jacobutermoehlen/SCOUT_RobotDog/Jetson_testCodes/laneFinding/test_image3.jpg

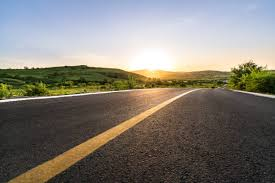
Jetson_testCodes/laneFinding/test_image3.jpg
