jacobutermoehlen/SCOUT_RobotDog/Plakat Texte und Bilder/CAD Design/CADModel.png

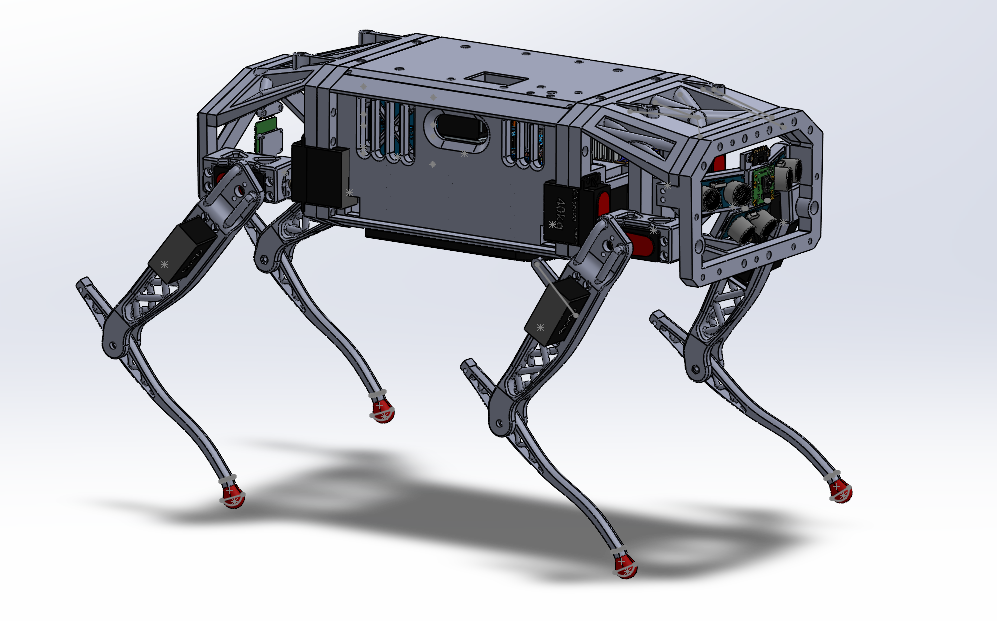
Plakat Texte und Bilder/CAD Design/CADModel.png
