jacobutermoehlen/SCOUT_RobotDog/Plakat Texte und Bilder/CAD Design/CAD-Design_Text.docx

Das 3D-Modell wurde in Solidworks entwickelt und für den 3D-Druck optimiert. Die modulare Bauweise bietet Platz für große Batterien, Sensoren und Kameras. Zudem ermöglicht das Design einfache Upgrades und eine kostengünstige Herstellung.

_____________________________________________________________________
