jacobutermoehlen/SCOUT_RobotDog/Plakat Texte und Bilder/Bewegung/Kinematik/Berechnung der inversen Kinematik.odt

Berechnung der inversen Kinematik

Gesucht:

Winkel ω

Winkel φ

Winkel θ

Gegeben:

Koordinaten = {x, y, z}

Länge A

Länge E

Länge F
