jacobutermoehlen/SCOUT_RobotDog/Vorstellungsablauf_Jacob.odt

- Elektronik
  - Komponentenwahl
  - Welche Komponenten
  - Wie arbeiten sie zusammen?
  - Sensoren
- Gehen und Fortbewegung
  - Gehbewegung der Beine
    - Bezier-Kurve
  - Koordination
  - Schrittart
  - Probleme der Fortbewegung
    - Wackelig
    - Schrittweite, Geschwindigkeit und Synchronisation
  - Testversuche und Teststand
- Software
  - Aufbau
  - Funktionsweise
    - WLAN-Hotspot
    - TCP-Port
  - Threads
  - Was macht der Code?
  - Kamerasystem
  - Autonomie
    - Sensoren
      - GPS, Distanz, Lage IMU
    - Wegfindung
    - Kommunikation mit Benutzer
- Integration
  - Probleme
