jacobutermoehlen/SCOUT_RobotDog/Serial String Communication for HERO.odt

Serial String Communication for HERO

Sensor ESP32

sensor data string

“SENSOUT,[tof_front],[tof_back],[hc_left],[hc_right],[hc_frontLeft],[hc_frontRight],[hc_down], [icm _pitch],[icm_roll],[icm_magX],[icm_magY],[icm_magZ],[icm_temp],[ina_vbus]“
