jacobutermoehlen/SCOUT_RobotDog/Plakat Texte und Bilder/Elektronik/Elektronik.odt

Elektronik

SCOUTs Elektronik System besteht aus über 30 Komponenten und einer selbstgebauten Platine.

Liste aller elektronischen Komponenten:

- 12x RC Servos mit 40kg/cm Drehmoment
- 1x Jetson Orin Nano Der Jetson Orin Nano ist der Hauptcomputer des Roboters. Alle Sensoren werden von einem ESP 32 ausgelesen. Die Sensordaten werden über das I2C Protokoll an der Jetson gesendet.
- 2x ESP 32
- 1x Servokontroller
- 1x DC-DC Konverter 30A
- 2x DC-DC Konverter 3A
- 5x HC-SR04 Ultraschallsensoren
- 2x Laser Distanzsensoren
- 1x 9-Achsen inertiale Messeinhheit
- 1x Spannungsmesser
- 1x Buzzer
- 1x Kamera
- 1x 25.2V LiPo Akku mit 5Ah
