jacobutermoehlen/SCOUT_RobotDog/Plakat Texte und Bilder/Beine und Füße/Foot and Leg_text.docx

Die Beine des Roboters sind robust und widerstandsfähig konstruiert, mit optimierter Druckorientierung für mehr Stabilität. Leistungsstarke Servomotoren mit 40 kg/cm Drehmoment ermöglichen eine präzise Bewegung. Weiche Gummifüße sorgen für besseren Halt auf verschiedenen Oberflächen.

_____________________________________________________________________

Evolution der Beine
