jacobutermoehlen/SCOUT_RobotDog/Plakat Texte und Bilder/Bewegung/Gehen.odt

Gehen

Jedes Bein von SCOUT muss bestimmten Punkten im 3D-Raum folgen, damit eine Gehbewegung erfolgt.

Die erste Gehbewegung sind vier Punkte als Trapez angeordnet gewesen, welche jedes Bein nacheinander durchläuft. Bei Test bemerkten wir schnell, dass das Bein stark wackelt und sich unruhig bewegt.

Wir führten das Problem auf den Weg, den das Bein Folgen muss, zurück. Am Ende des Bodenkontaktes hat sich das Bein ruckartig in die entgegengesetzte Seite bewegt was für die Motoren schwierig ist.

In einem neuen Versuch haben wir den Anfang und Ende des Bodenkontaktes mit einer quadratischen Bezier-Kurve stumpf gemacht, so dass die Richtungsänderung ruhig verläuft und die Motoren unter weniger Belastung Stehen.

Formel der Bezier-Kurve:

Punkte P0, P1 und P2 sind Kontrollpunkte, durch welche die Kurve gesteuert wird. Die Funktion P(t) erstellt Punkte auf dieser Kurve.

Kurven

Wenn SCOUT eine Kurve gehen soll, dann werden alle Wegpunkte des Gehzyklus‘ um Winkel α im 3D-Raum gedreht.

Die neu errechneten Punkte werden den vorderen Beinen zugewiesen, so dass SCOUT eine Kurve läuft.
