jacobutermoehlen/SCOUT_RobotDog/Plakat Texte und Bilder/Software/Software.odt

Software

SCOUTs Softwaresystem besteht hauptsächlich aus einem großen Python Code. Dieser läuft lokal auf dem Jetson Orin Nano und ist zuständig für:

- Kommunikation mit dem GUI
- Berechnung von Wegpunkten der Gehbewegung
- Berechnung der Kinematik
- Steuerung und Koordination der Motoren

Der Code ist in Threads aufgeteilt. Threads sind Codeabschnitte die parallel zueinander auf verschiedenen CPU-Kernen ausgeführt werden. Dadurch kann z.B. dauerhaft zwischen mit dem GUI kommuniziert werden während gleichzeitig die Motoren gesteuert werden.
