jacobutermoehlen/SCOUT_RobotDog/Plakat Texte und Bilder/Bewegung/bewegung bilder und texte/Geh-Bewegung_Text.docx

Quadratische Bézier-Kurven wurden verwendet, um ungewollte Richtungsänderungen zu vermeiden und die Bewegung flüssiger zu gestalten. Sie passen die Geschwindigkeit und Richtung sanft an, wodurch die Gehbewegung gleichmäßiger wird. Die Schrittweite ist variabel und hängt von der Distanz der gespiegelten Kurven ab.

________________________________________
