jacobutermoehlen/SCOUT_RobotDog/Drawings/Flowchart_ServoESP32.drawio.pdf

# Servo ESP32

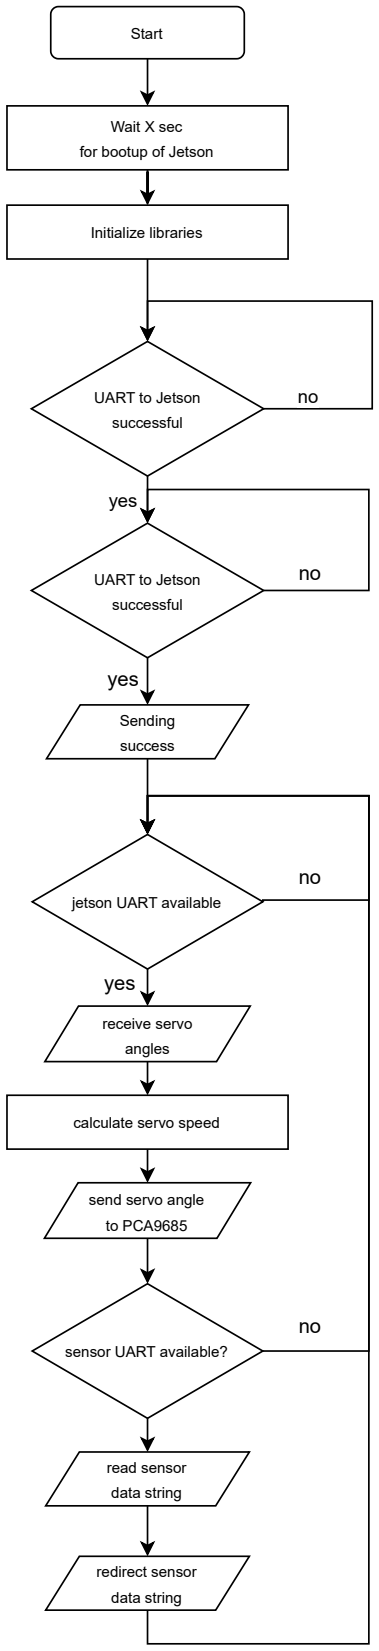
[picture p29: figure]
Start; Wait X sec for bootup of Jetson; Initialize libraries; yes; UART to Jetson successful; Sending success; sensor UART available?; read sensor data string; jetson UART available; redirect sensor data string; receive servo angles; calculate servo speed; send servo angle to PCA9685
