jacobutermoehlen/SCOUT_RobotDog/Plakat Texte und Bilder/Bewegung/Kinematik/Kinematik2.odt

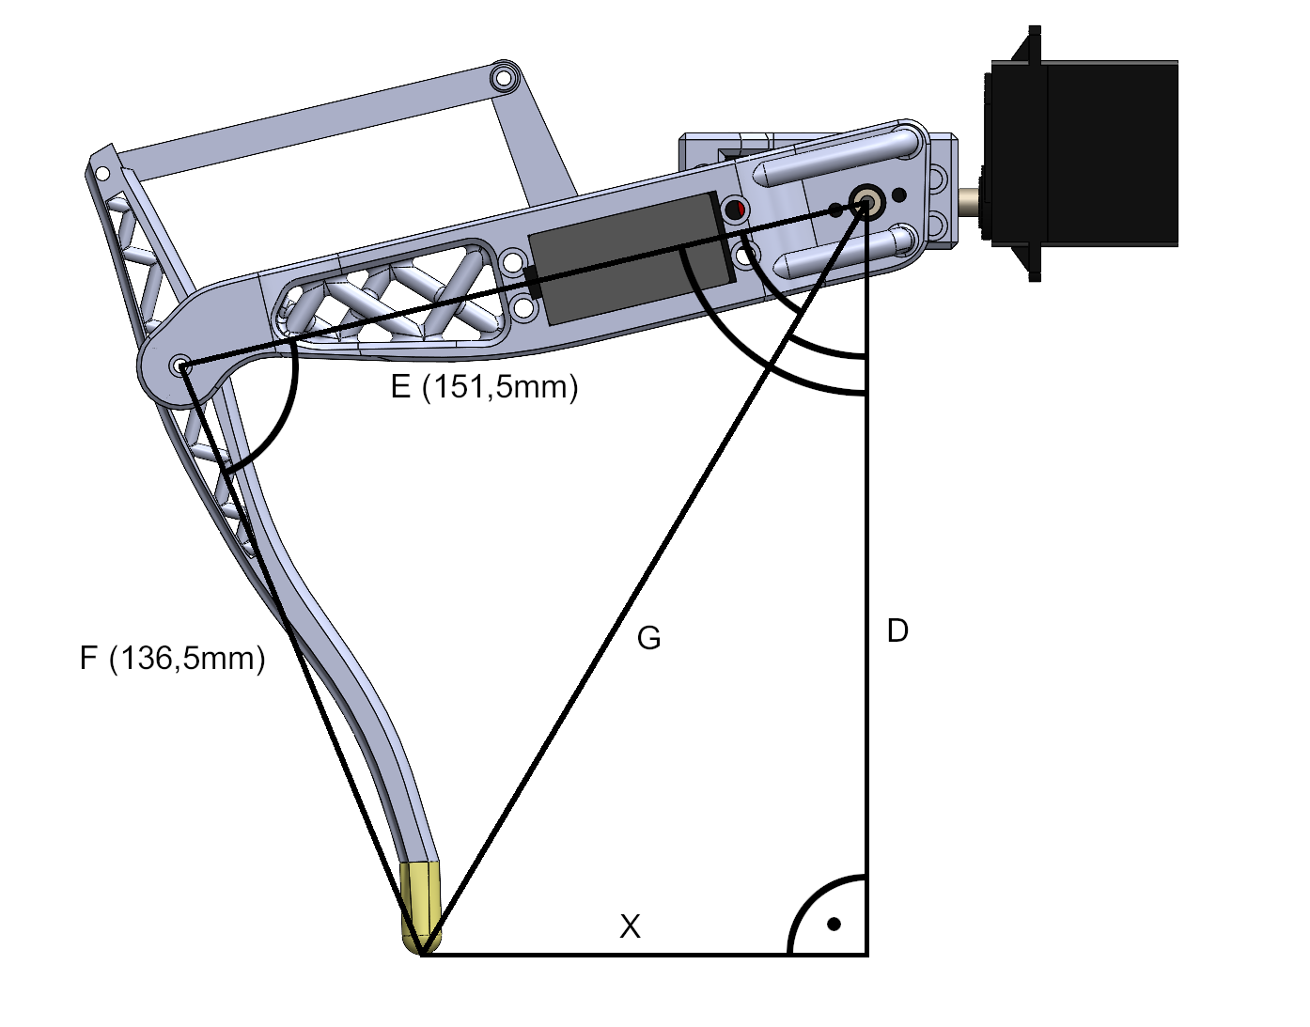
[picture p30: figure]
