jacobutermoehlen/SCOUT_RobotDog/Plakat Texte und Bilder/Bewegung/Kinematik/Berechnung der inversen Kinematik_eng.pdf

C = √Z
2 + Y

2

D = √C
2 − A

2

= √√Z
2 + Y

2 − A

2

α = tan⁻¹

Z
Y

β = tan⁻¹

D
A
ω = α + β

needed:

angle ω

angle φ

angleθ

given:

coordinates = {x, y, z}

length A

length E

length F

G = √D² + X
2

G

2 = E

2 + F

2 − 2EF × cos φ

φ = cos⁻¹

G

2 − E

2 − F

2
−2EF

γ = tan⁻¹

(

X
D

)

δ = sin⁻¹

(

sinφ
G

× F)

θ = γ + δ

ω = tan⁻¹

Z
Y

+ tan⁻¹

√√Z
2 + Z

2 − A

2
A

φ = cos⁻¹

G

2 − E

2 − F

2
−2EF

θ = tan⁻¹

(

X
D

) + sin⁻¹ (
sin (cos⁻¹

(

G

2 − E

2−F

2
−2EF ))

G

× F)
