jacobutermoehlen/SCOUT_RobotDog/3DParts/LowerLeg-Static 1/LowerLeg-Static 1-Displacement-Displacement1.jpg

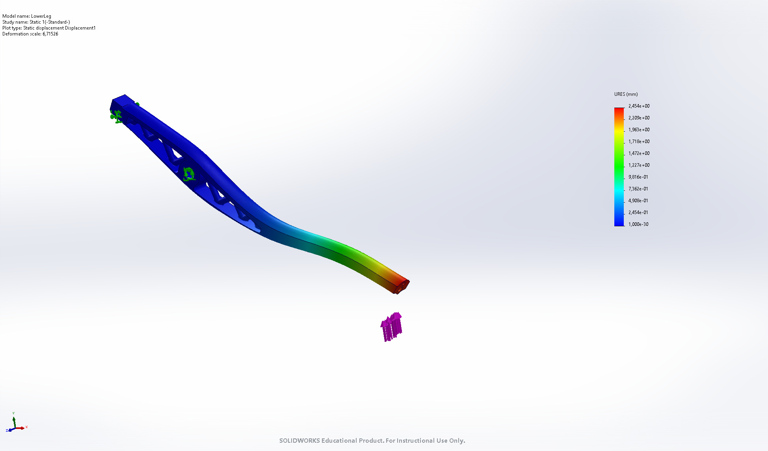
3DParts/LowerLeg-Static 1/LowerLeg-Static 1-Displacement-Displacement1.jpg
