jacobutermoehlen/SCOUT_RobotDog/Images/015D5AFA-F840-42FB-8E8E-D22241E1A85D.JPG

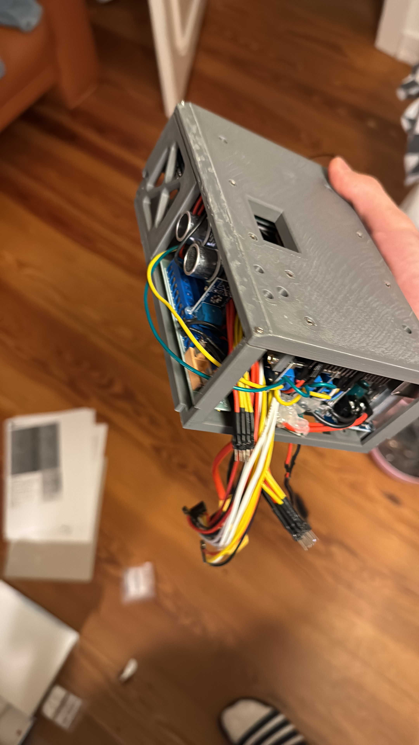
Images/015D5AFA-F840-42FB-8E8E-D22241E1A85D.JPG
