jacobutermoehlen/SCOUT_RobotDog/Images/BDSpotReference.jpg

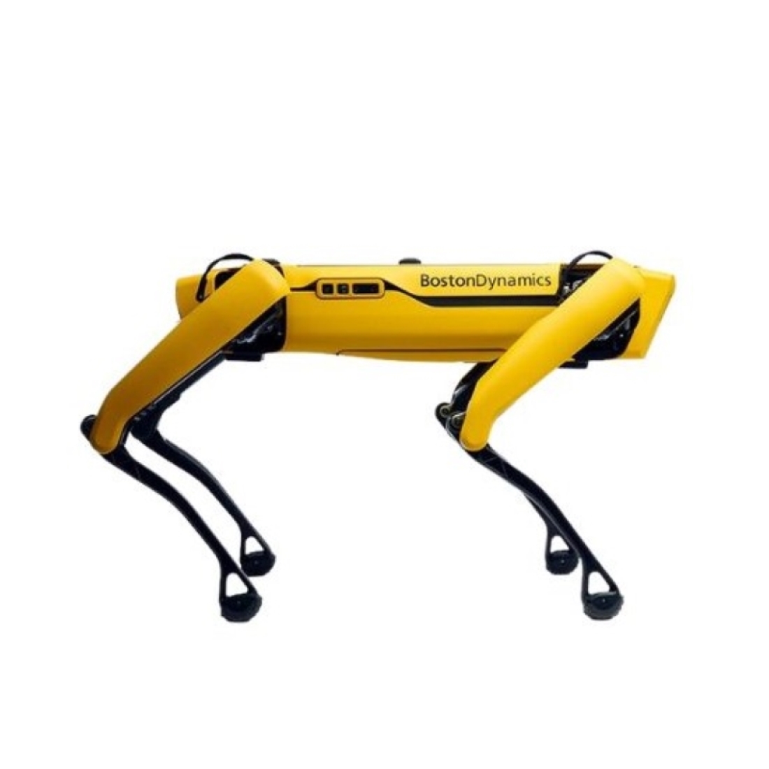
Images/BDSpotReference.jpg
