jacobutermoehlen/SCOUT_RobotDog/Images/IMG_0658.jpg

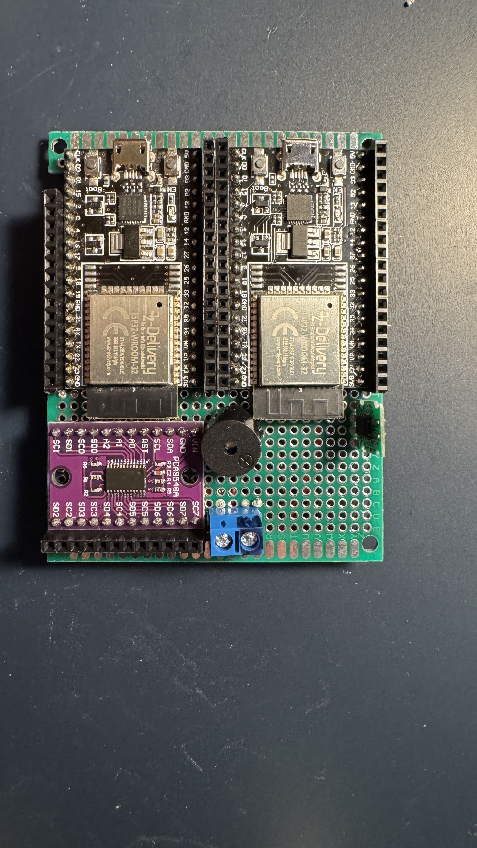
Images/IMG_0658.jpg
