jacobutermoehlen/SCOUT_RobotDog/Images/IMG_0659.jpg

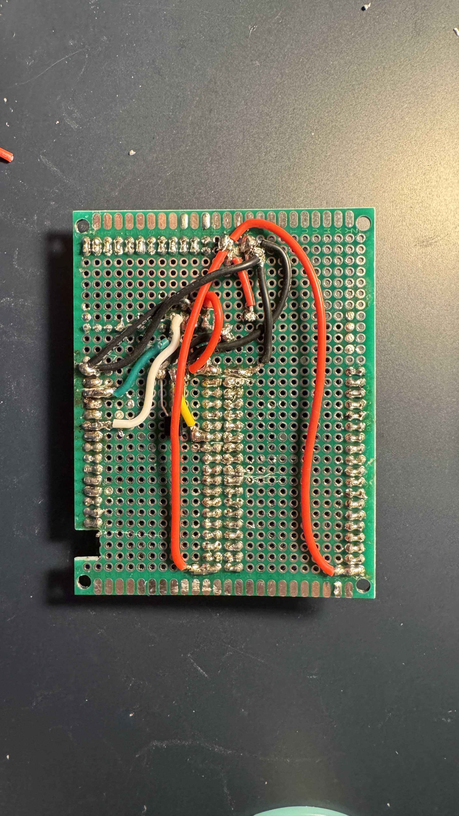
Images/IMG_0659.jpg
