jacobutermoehlen/SCOUT_RobotDog/Images/IMG_0660.jpg

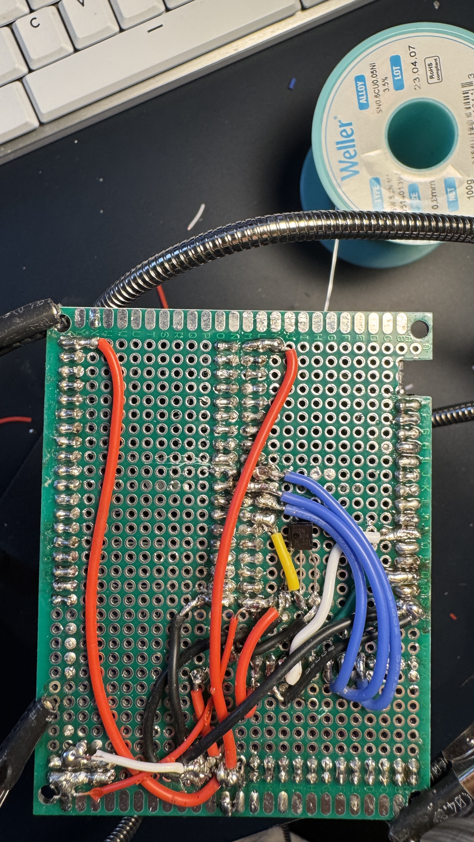
Images/IMG_0660.jpg
