jacobutermoehlen/SCOUT_RobotDog/Images/IMG_0661.jpg

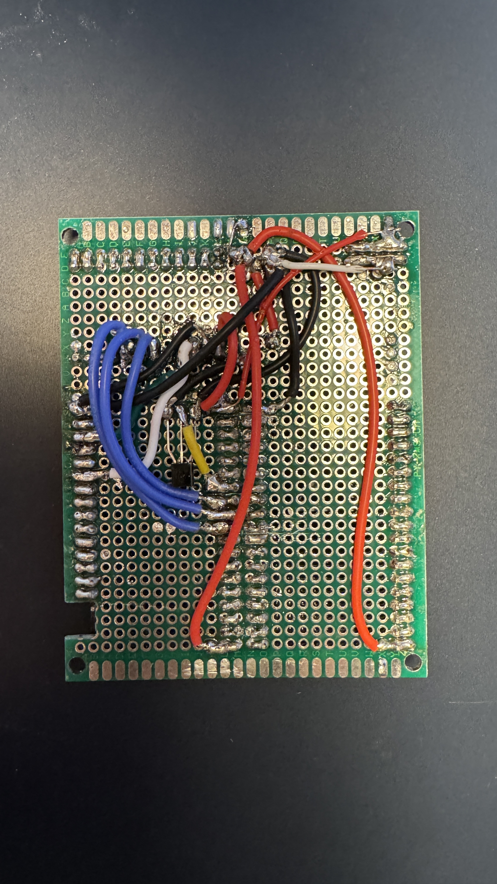
Images/IMG_0661.jpg
