jacobutermoehlen/SCOUT_RobotDog/Images/IMG_0662.jpg

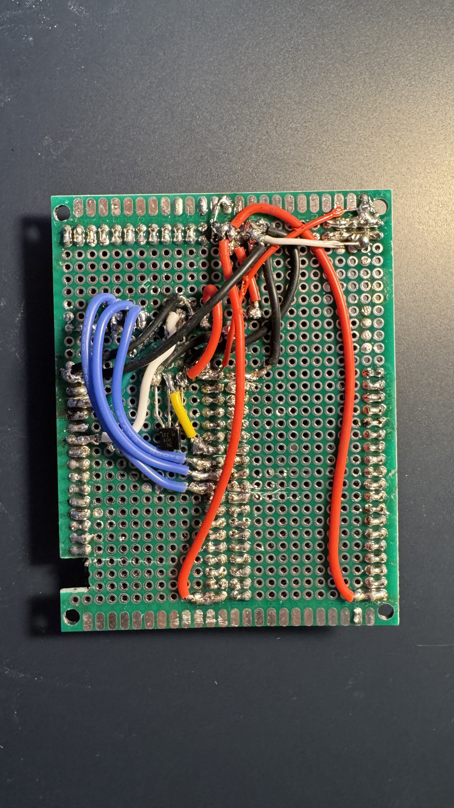
Images/IMG_0662.jpg
