jacobutermoehlen/SCOUT_RobotDog/Images/IMG_0664.jpg

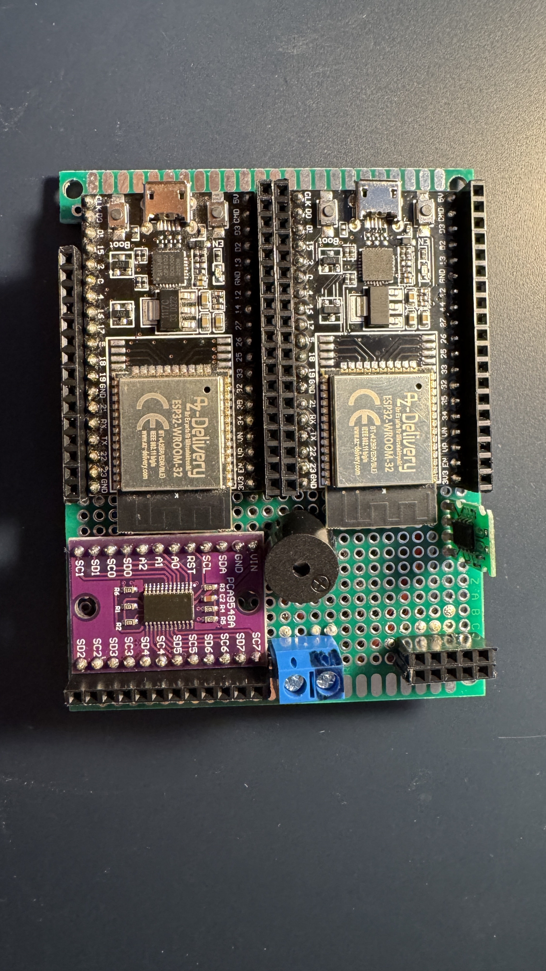
Images/IMG_0664.jpg
