jacobutermoehlen/SCOUT_RobotDog/Images/IMG_0666.jpg

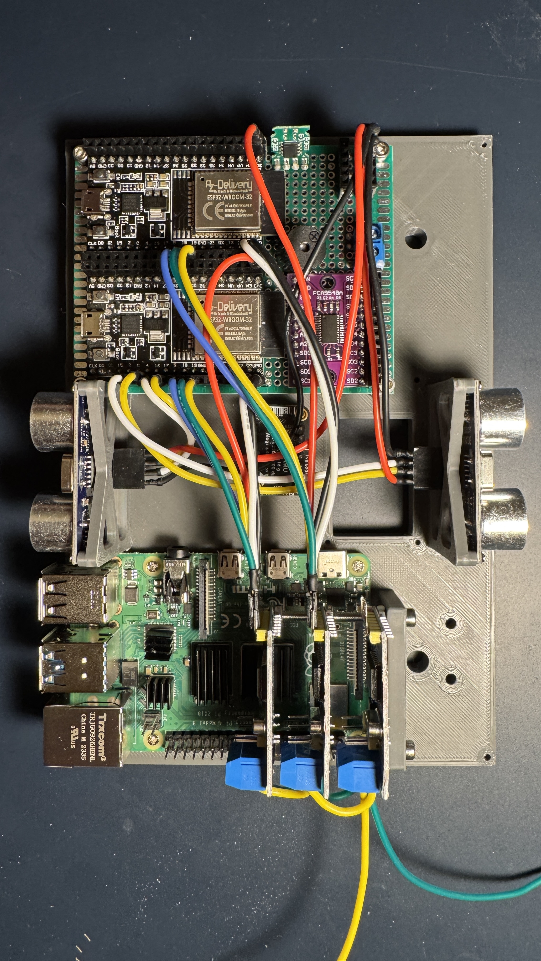
Images/IMG_0666.jpg
