jacobutermoehlen/SCOUT_RobotDog/Images/IMG_0667.jpg

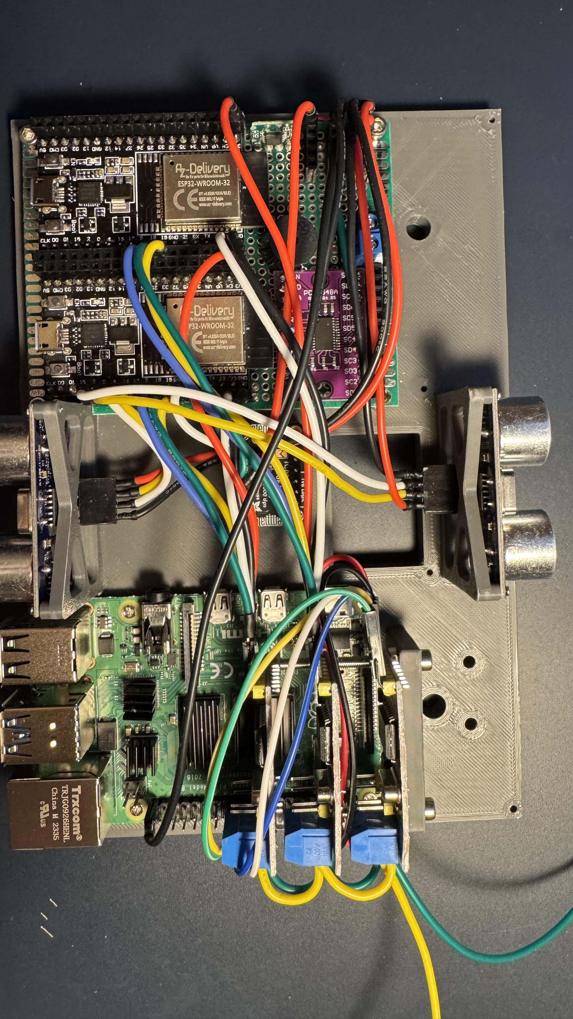
Images/IMG_0667.jpg
