jacobutermoehlen/SCOUT_RobotDog/Images/IMG_0668.jpg

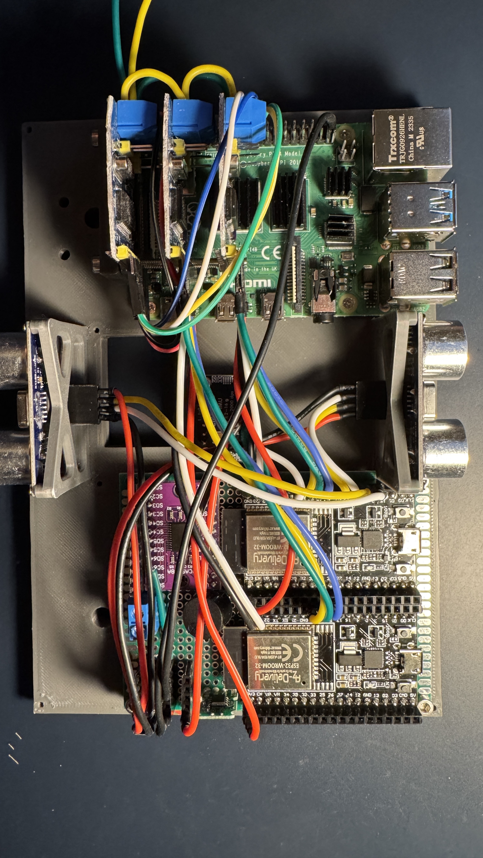
Images/IMG_0668.jpg
