jacobutermoehlen/SCOUT_RobotDog/Images/IMG_0670.jpg

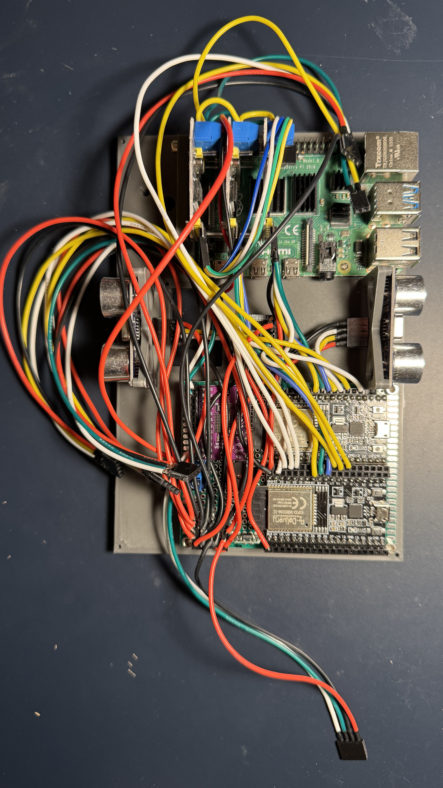
Images/IMG_0670.jpg
