jacobutermoehlen/SCOUT_RobotDog/Images/IMG_0671 1.jpg

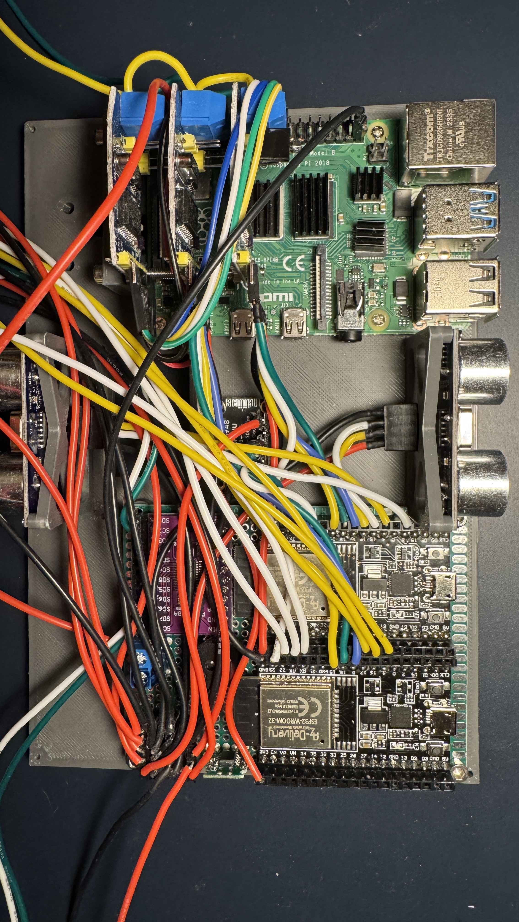
Images/IMG_0671 1.jpg
