jacobutermoehlen/SCOUT_RobotDog/Images/IMG_0674.jpg

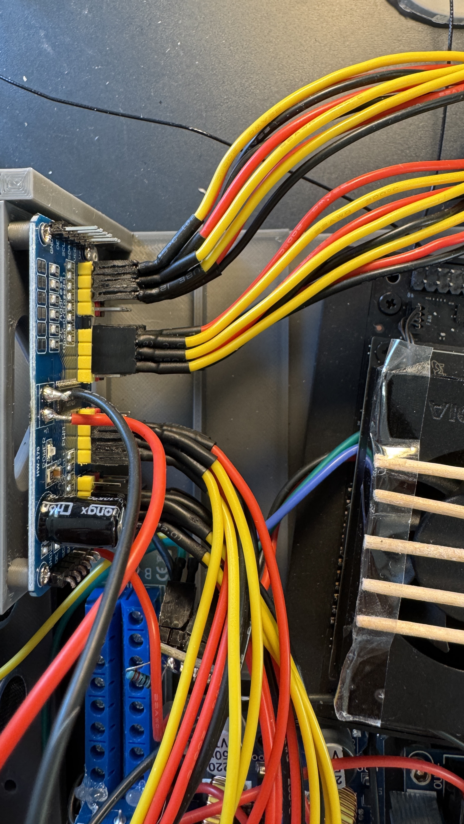
Images/IMG_0674.jpg
