jacobutermoehlen/SCOUT_RobotDog/Images/IMG_0720.jpg

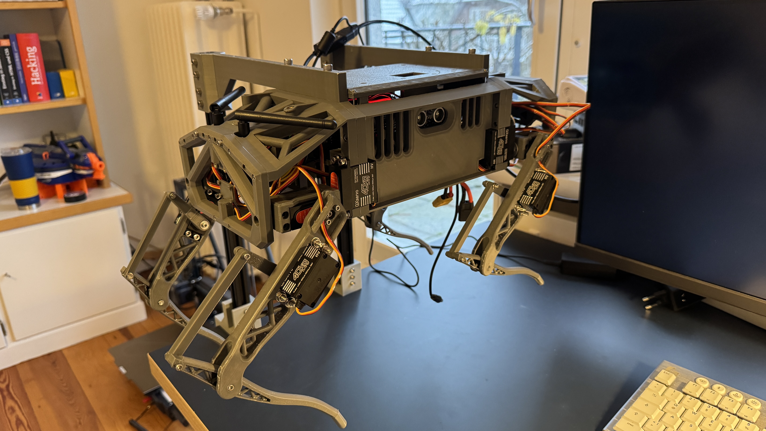
Images/IMG_0720.jpg
