jacobutermoehlen/SCOUT_RobotDog/Images/KinematicsCalculation1.png

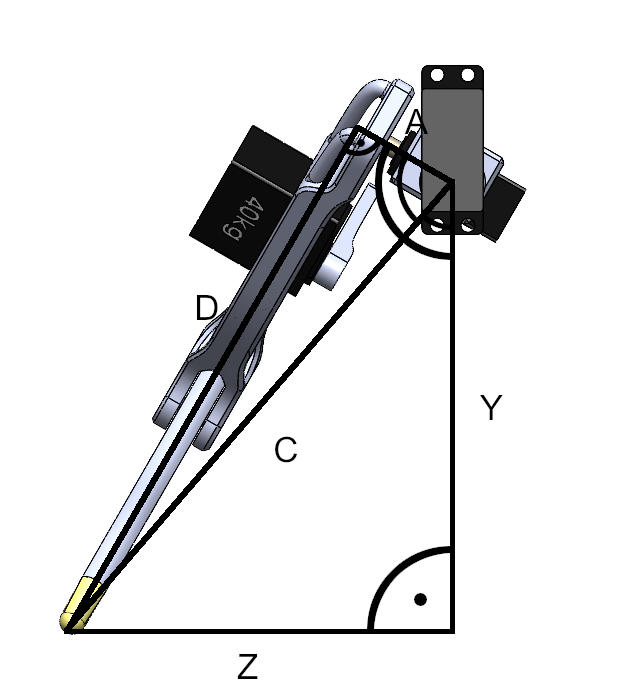
Images/KinematicsCalculation1.png
