jacobutermoehlen/SCOUT_RobotDog/Images/LowerLeg_Stress_10N.png

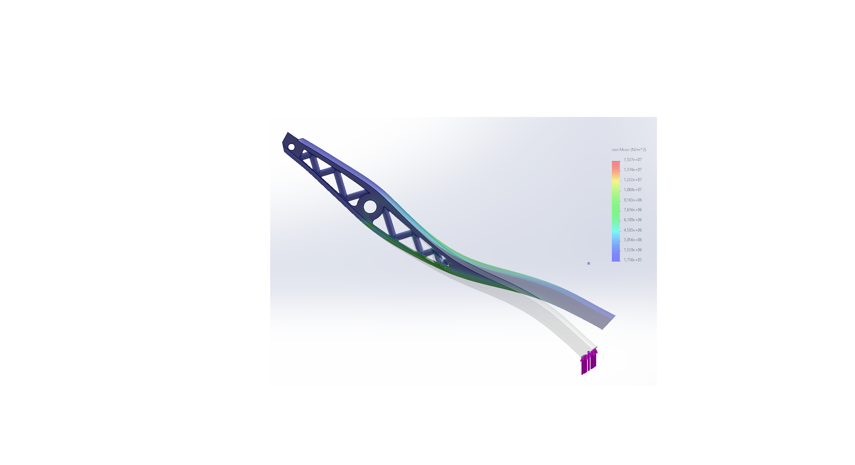
Images/LowerLeg_Stress_10N.png
