jacobutermoehlen/SCOUT_RobotDog/Images/SCOUTinVirtualEnviroment.png

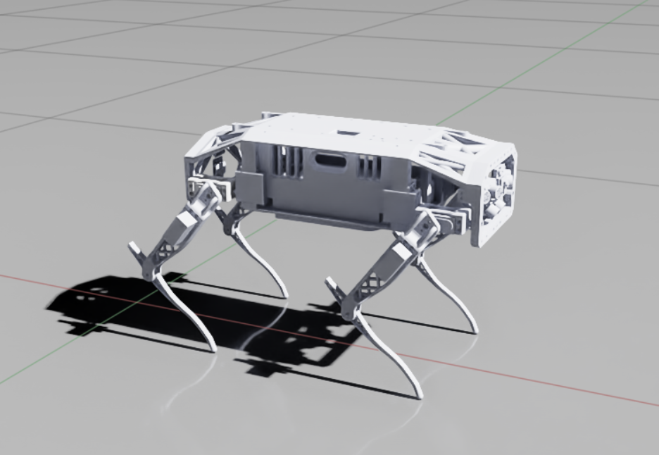
Images/SCOUTinVirtualEnviroment.png
