jacobutermoehlen/SCOUT_RobotDog/Images/Screenshot 2024-10-02 110427.png

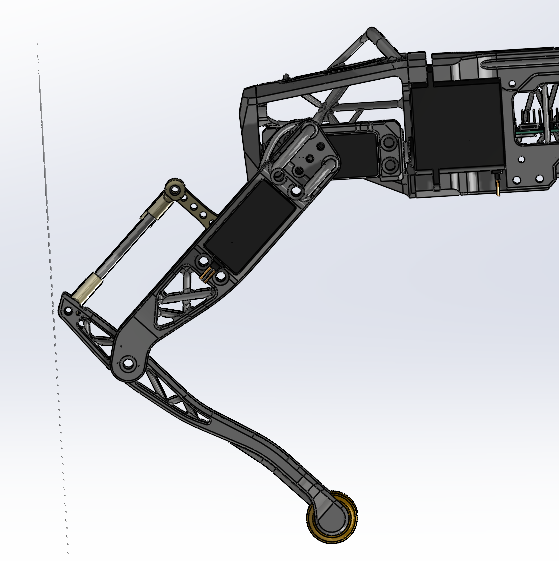
Images/Screenshot 2024-10-02 110427.png
