jacobutermoehlen/SCOUT_RobotDog/Images/Screenshot 2025-01-12 144651.png

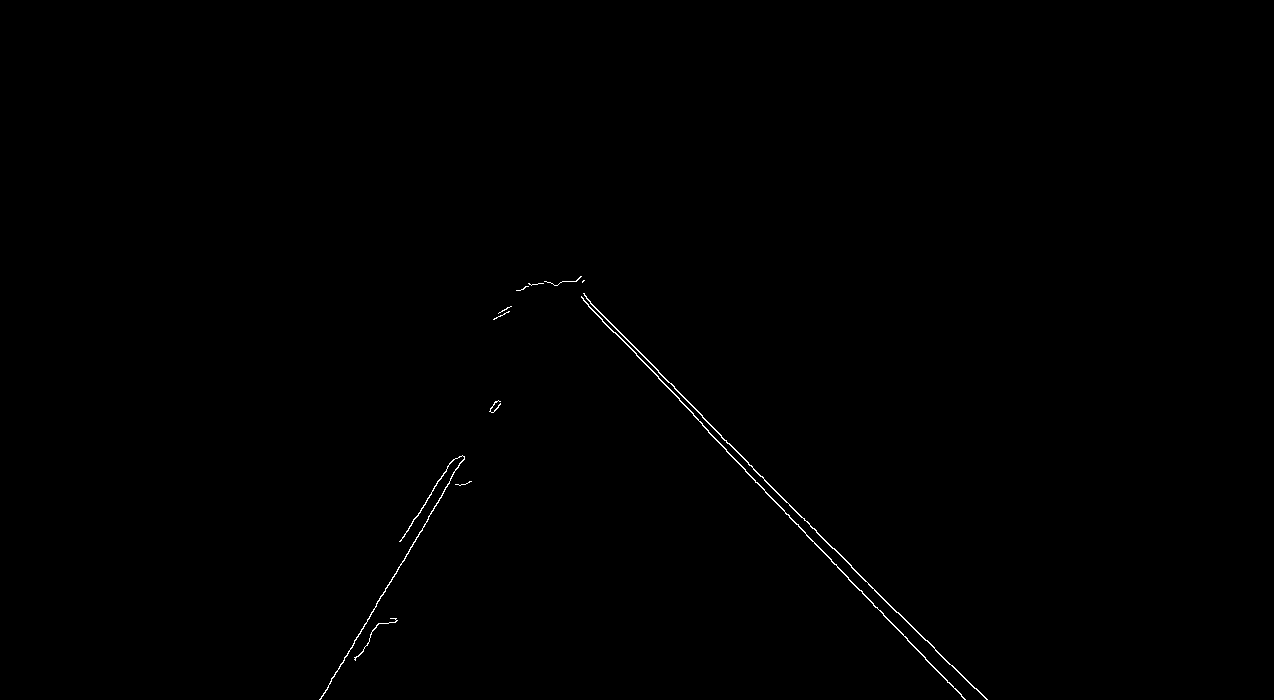
Images/Screenshot 2025-01-12 144651.png
