jacobutermoehlen/SCOUT_RobotDog/Images/Screenshot 2025-02-14 063028.png

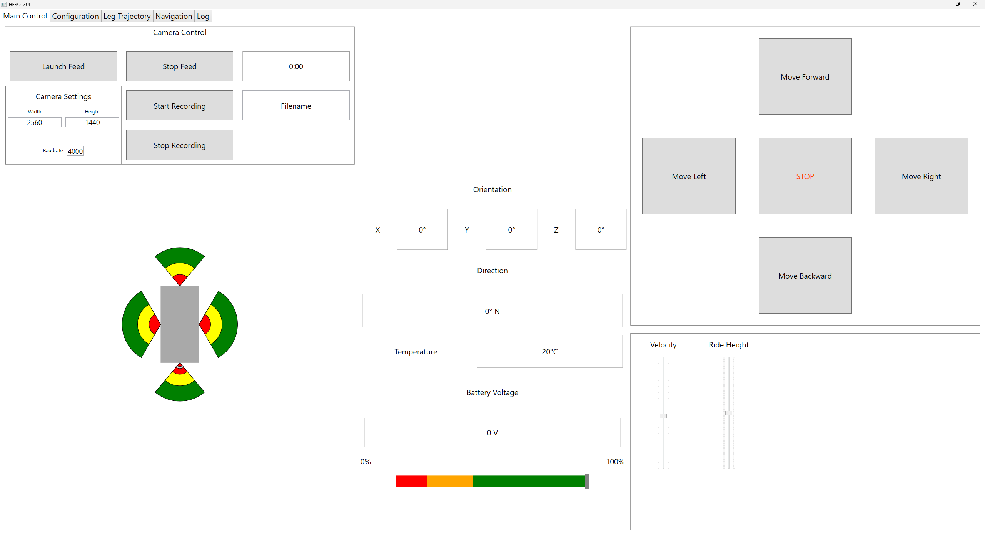
Images/Screenshot 2025-02-14 063028.png
