jacobutermoehlen/SCOUT_RobotDog/Images/Screenshot 2025-05-04 125850.png

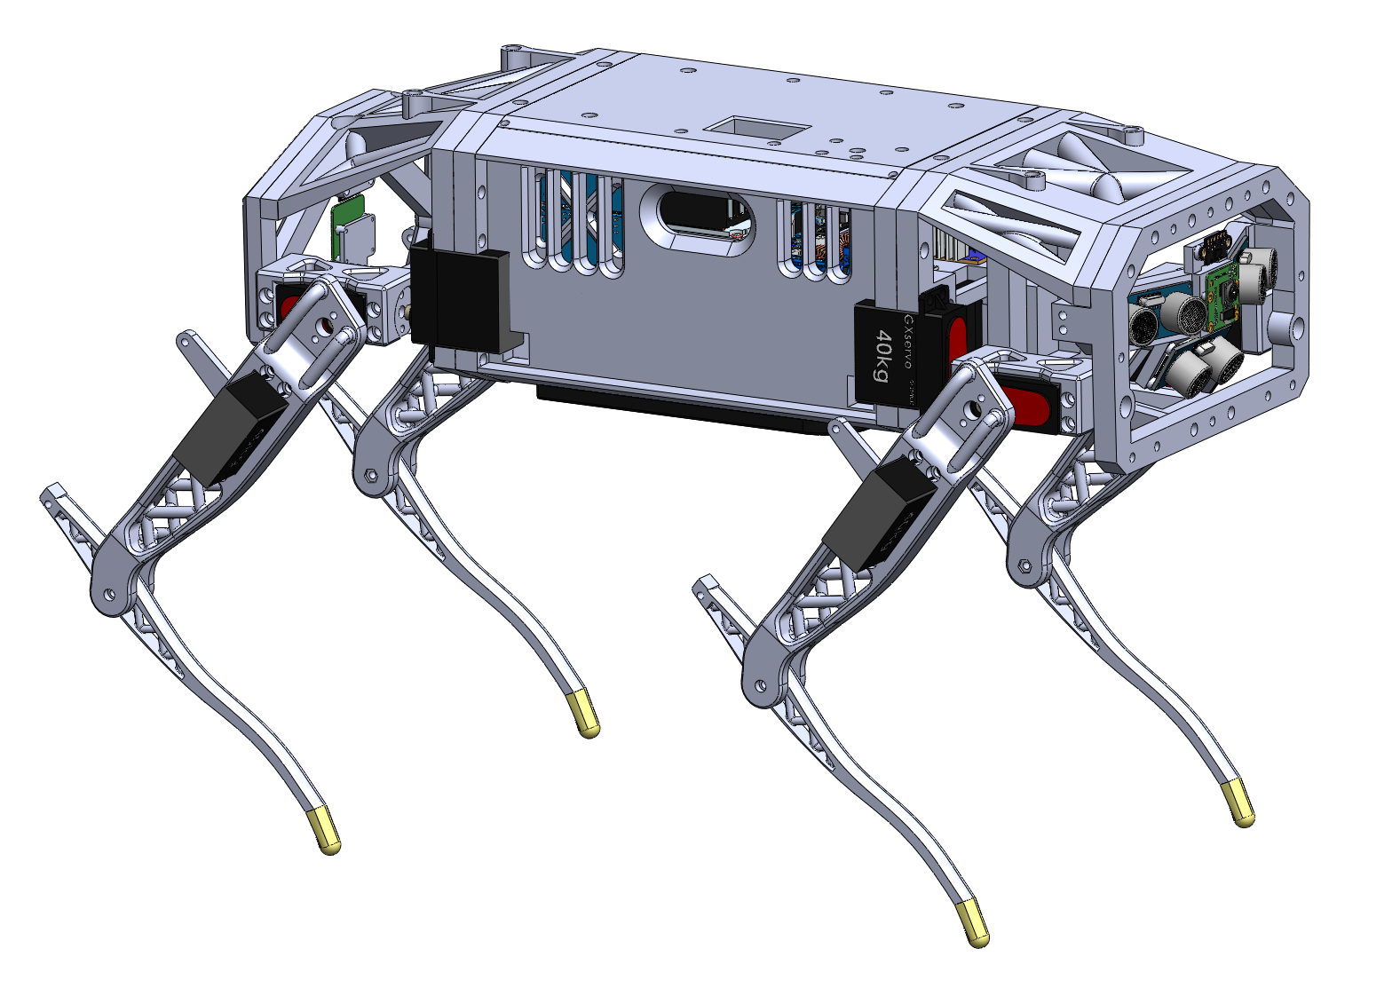
Images/Screenshot 2025-05-04 125850.png
