jacobutermoehlen/SCOUT_RobotDog/Plakat Texte und Bilder/Beine und Füße/Foots.jpg

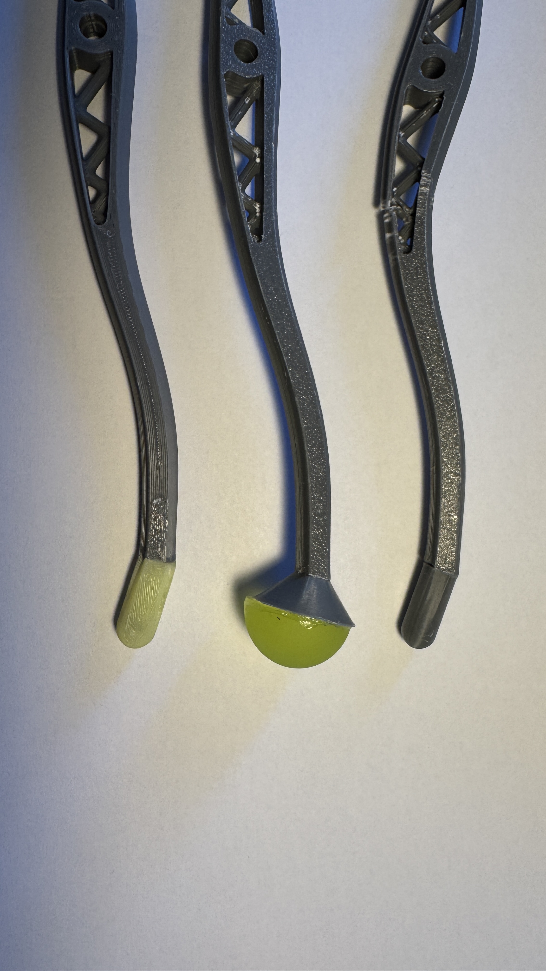
Plakat Texte und Bilder/Beine und Füße/Foots.jpg
