jacobutermoehlen/SCOUT_RobotDog/Plakat Texte und Bilder/Beine und Füße/Leg.png

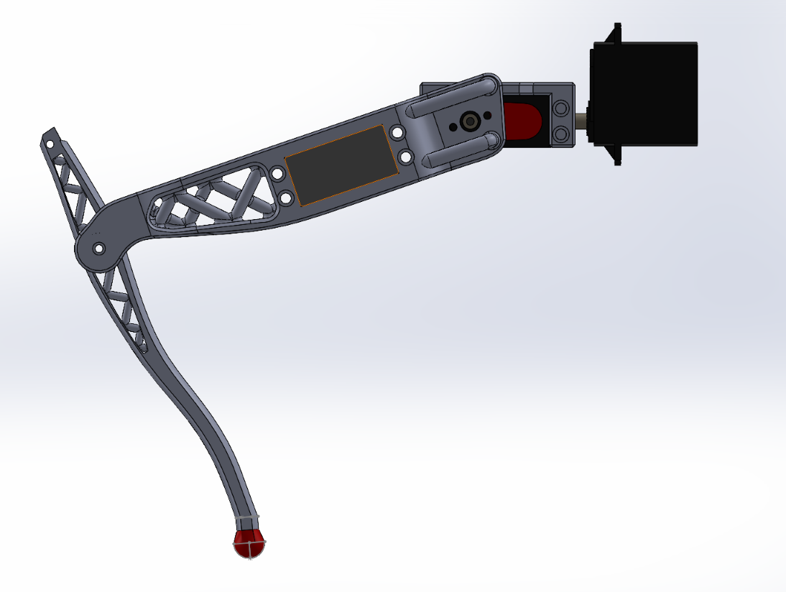
Plakat Texte und Bilder/Beine und Füße/Leg.png
