jacobutermoehlen/SCOUT_RobotDog/Plakat Texte und Bilder/Bewegung/Kinematik/Screenshot 2025-02-09 204644.png

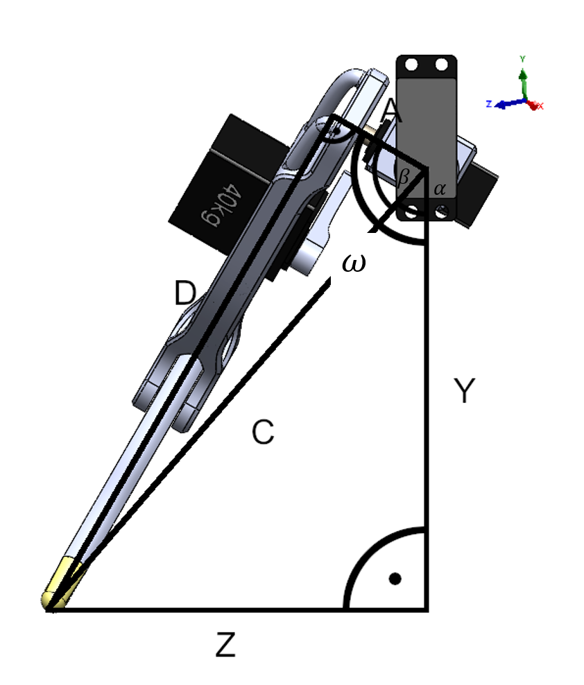
Plakat Texte und Bilder/Bewegung/Kinematik/Screenshot 2025-02-09 204644.png
