jacobutermoehlen/SCOUT_RobotDog/Plakat Texte und Bilder/CAD Design/BDSpotReference.png

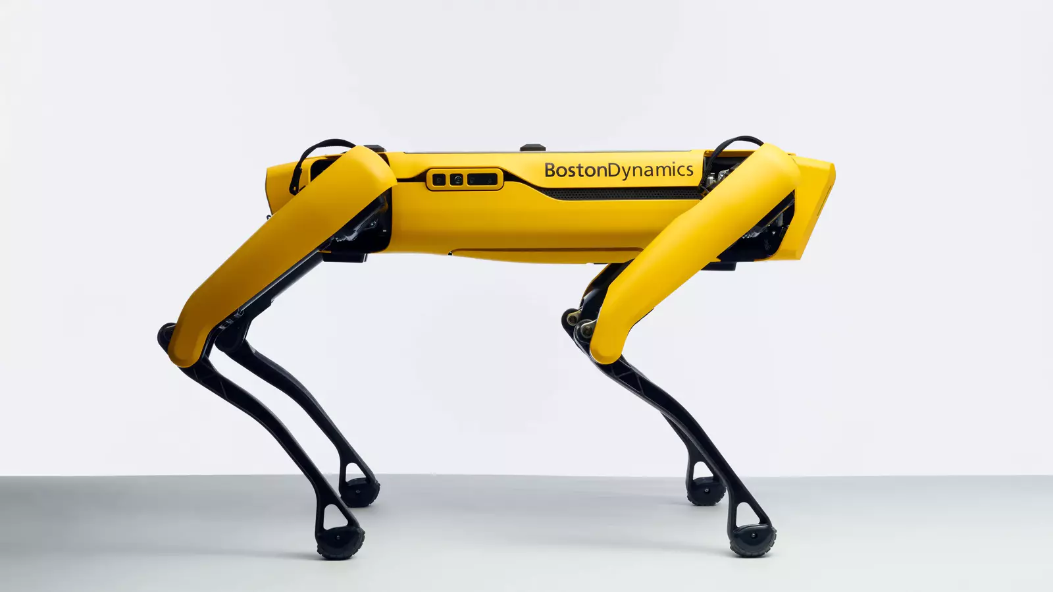
Plakat Texte und Bilder/CAD Design/BDSpotReference.png
