jacobutermoehlen/SCOUT_RobotDog/Partlist for bangle.xlsx

Produkt | Funktion | Preis | Anzahl | Paket Anzahl | Link | Gesamtpreis
H31 batterie 3,7 500 v 3,7 mah | Energie versorgung | 2.69 € | 1 | 1 | Klick Hier (https://de.aliexpress.com/item/1005007782013064.html?mp=1) | 2.69 €
TF Micro SD-Kartenmodu | Speicherung der Audiodatein | 2.69 € | 10 | 1 | Klick Hier (https://de.aliexpress.com/item/1005006247350757.html?mp=1) | 2.69 €
Tactile Push Button | Aktivierung der Audioeingabe | 1.79 € | 20 | 1 | Klick Hier (https://de.aliexpress.com/item/1005007078128171.html?mp=1) | 1.79 €
ESP-WROOM-32 ESP32-S entwicklung board | Computer/ Steuersystem | 6.39 € | 1 | 1 | Klick Hier (https://de.aliexpress.com/item/1005006490116433.html?mp=1) | 6.39 €
SPH0645 I2S MEMS Mikrofon | Aufnahme des Audios | 4.39 € | 1 | 1 | Klick Hier (https://de.aliexpress.com/item/4000059212862.html?mp=1) | 4.39 €
Gesamt: |  | 17.95 € |  |  |  | 17.95 €
