jacobutermoehlen/SCOUT_RobotDog/PartList.xlsx

 | Name | Info | Pack Anzahl | Bestellanzahl | Gesamtanzahl | URL | Preis pro Pack | Preis insgesamt | Bestellt | Vorhanden | Ausgezahlt | Auszahlungswert | Versand
Elektronik | Raspberry Pi | Raspberry Pi4 4Gb | 1 | 1 | 1 | Hier Klicken (https://www.amazon.de/gp/product/B09TTNF8BT/ref=ox_sc_act_title_5?smid=A1JDLVO3NW19TT&psc=1) | 60.49 € | 60.49 € | TRUE | TRUE | FALSE | 60.49
 | SanDisk Ultra 256Gb | - | 1 | 1 | 1 | Hier Klicken (https://www.amazon.de/gp/product/B0B7NV73PJ/ref=ox_sc_act_title_19?smid=A3JWKAKR8XB7XF&psc=1) | 19.03 € | 19.03 € | TRUE | TRUE | FALSE | 19.03
 | Gxservo 40kg | 40kg RC Servo QY3240MG Digital Servo 7.4V | 1 | 12 | 12 | Hier Klicken (https://de.aliexpress.com/item/1005005565497730.html?mp=1) | 14.91 € | 178.92 € | TRUE | TRUE | FALSE | 178.92
 | Haileg PCA9685 Servoboard | Hailege 2pcs PCA9685 16 Kanal IIC I2C 12-Bit PWM Servomotor | 1 | 1 | 1 | Hier Klicken (https://de.aliexpress.com/item/1005006342114169.html) | 5.21 € | 5.21 € | TRUE | TRUE | FALSE | 5.21
 | Turnigy Rapid 5000mAh 6s Lipo | 5000mAh 6s (22,2) 100C LiPo Battery Pack w/XT90 Connector | 1 | 1 | 1 | Hier Klicken (https://hobbyking.com/de_de/turnigy-rapid-5000mah-6s-22-2v-100c-lipo-battery-pack-w-xt90-connector.html) | 42.00 € | 42.00 € | TRUE | TRUE | FALSE | 42
 | APKLVSR Pi Kamera 5MP | 1080p Kamera mit Nachtsicht | 1 | 1 | 1 | Hier Klicken (https://www.amazon.de/APKLVSR-Kompatibel-Kameramodul-Einstellbare-Infrarot-IR-LED-Licht/dp/B0CLGTM3Z8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) | 11.59 € | 11.59 € | TRUE | TRUE | FALSE | 11.59
 | Servo Tester | Servo Tester 4,2-6V 3-Gang-Schalter | 1 | 1 | 1 | Hier Klicken (https://de.aliexpress.com/item/1005007097121696.html?mp=1) | 1.55 € | 1.55 € | FALSE | FALSE | FALSE | 0
 | XL6009 4A Converter |  | 5 | 1 | 5 | Hier Klicken (https://de.aliexpress.com/item/1005006954848559.html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) | 4.19 € | 4.19 € | FALSE | FALSE | FALSE | 0
 | On Off Schalter | Kippschalter schwarz | 5 | 1 | 5 | Hier Klicken (https://de.aliexpress.com/item/32873386670.html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) | 1.19 € | 1.19 € | FALSE | FALSE | FALSE | 0
 | 4A Sicherung Wiederverwendbar | rücksetbarer Leistungsschalter 4A max. | 5 | 1 | 5 | Hier Klicken (https://de.aliexpress.com/item/1005006243840332.html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) | 4.37 € | 4.37 € | TRUE | FALSE | FALSE | 4.37
 | Notfall Stop | 22mm Notfallstop Mushroom Push Button 600V/10A | 1 | 1 | 1 | Hier Klicken (https://de.aliexpress.com/item/4000350288660.html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) | 1.89 € | 1.89 € | FALSE | FALSE | FALSE | 0
 | ESP32-C6 DevKit | ESP32-C6 DevKit 512Kb Sram 4Mb Flash WiFi-6 | 2 | 1 | 2 | Hier Klicken (https://www.amazon.de/ESP32-C6-DevKitC-1-N4-Entwicklungsplatine-RUIZHI-Unterst%C3%BCtzt-Schnittstelle/dp/B0CPY6NV6L) | 14.99 € | 14.99 € | FALSE | FALSE | FALSE | 0
 | Raspberry Pi Kühlkörper Alu | GeekPi Kühlkörper für Raspberry Pi 4 | 8 | 1 | 8 | Hier Klicken (https://www.amazon.de/gp/product/B085G73SCB/ref=ppx_yo_dt_b_asin_title_o00_s01?ie=UTF8&th=1) | 4.99 € | 4.99 € | TRUE | TRUE | FALSE | 4.99
 | HC-SR04 Ultrasonic sensor | HC-SR04 Ultraschall Distanzsensor | 5 | 1 | 5 | Hier Klicken (https://www.amazon.de/HC-SR04-Ultraschall-Sensor-Ultraschallsensor-Arduino-MEGA2560/dp/B07XF4815H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) | 15.78 € | 15.78 € | TRUE | TRUE | FALSE | 15.78 | 4
 | Turnigy ACCUCELL LiPo Charger | Turnigy (EU Plug) C150 LiPo AC/DC smart balance charger 150W | 1 | 1 | 1 | Hier Klicken (https://hobbyking.com/en_us/turnigy-eu-plug-accucell-c150-lihv-ac-dc-1-6s-10a-150w-smart-balance-charger.html) | 66.00 € | 66.00 € | TRUE | TRUE | FALSE | 66
 | Haileg XL4015 DC-DC Buck Converter | XL4015 DC-DC Buck Converter 4~38V to 1.25-36V 5A | 5 | 1 | 5 | Hier Klicken (https://www.amazon.de/gp/product/B07XRF9NWP/ref=ewc_pr_img_1?smid=A1A7E5ILEFA1R3&psc=1) | 15.78 € | 15.78 € | TRUE | TRUE | FALSE | 15.78
 | XT90 Ladekabel | 12AWG 30cm XT90-Bananenstecker Ladekabel | 2 | 1 | 2 | Hier Klicken (https://www.amazon.de/gp/product/B07JFCS9F4/ref=ox_sc_act_title_1?smid=A2ZY4SNMU91J2Q&th=1) | 8.99 € | 8.99 € | TRUE | TRUE | TRUE | 0
 | Raspberry Pi Camera |  | 1 | 1 | 1 |  | 42 € | 42.00 € | TRUE | TRUE | FALSE | 42
 | 300W 20A Buck Converter | 300W 200A Konstantstromkonverter | 2 | 1 | 2 | Hier Klicken (https://www.amazon.de/gp/product/B07J5663JW/ref=ox_sc_act_title_4?smid=A2DJ5UBBXXMLC9&psc=1) | 22.98 € | 22.98 € | TRUE | TRUE | FALSE | 22.98
 | VL53LOX ToF laser sensor |  | 1 | 2 | 2 | Hier Klicken (https://de.aliexpress.com/item/1005005127057518.html?mp=1) | 2.08 | 4.16 € | TRUE | TRUE | FALSE | 4.16
 | ICM-20948 9-DoF IMU (MPU-9250 Upgrade) | 9-Axis IMU | 1 | 1 | 1 | Hier Klicken (https://www.berrybase.de/adafruit-tdk-invensense-icm-20948-9-dof-imu-mpu-9250-upgrade) | 20.15 € | 20.15 € | TRUE | TRUE | FALSE | 20.15
 | AX210NGW Wi-Fi 6e Card |  | 1 | 1 | 1 | Hier Klicken (https://amzn.eu/d/3xkn2ML) | 24.69 € | 24.69 € | FALSE | FALSE | FALSE | 0
 | Wi-Fi 6e High Gain Antenna |  | 1 | 1 | 1 | Hier Klicken (https://amzn.eu/d/9PQU5eG) | 11.49 € | 11.49 € | TRUE | TRUE | FALSE | 11.49
 | Archer T3U Plus AC1300 USB-Antenna | TP-Link 5GHz, 2,4GHz USB Wlan Stick | 1 | 1 | 1 | Hier Klicken (https://amzn.eu/d/axZg33x) | 20.00 € | 20.00 € | TRUE | TRUE | FALSE | 20
 | Waveshare SN65HVD230 CAN Board |  | 1 | 1 | 1 | Hier Klicken (https://amzn.eu/d/3zZ0lFI) | 12.99 € | 12.99 € | TRUE | TRUE | FALSE | 12.99
 | MCP2515 CAN-Board Transceiver |  | 4 | 1 | 4 | Hier Klicken (https://amzn.eu/d/7rhdwHR) | 17.59 € | 17.59 € | TRUE | TRUE | FALSE | 17.59
 | 50A Hall Currentsensor |  | 1 | 1 | 0 | Hier Klicken (https://de.aliexpress.com/item/33045467824.html) | 3.38 € | 3.38 € | TRUE | TRUE | FALSE | 3.38
 | SN65HVD230 |  | 1 | 3 | 3 | Hier Klicken (https://de.aliexpress.com/item/1005005334841319.html) | 1.29 € | 3.87 € | TRUE | TRUE | FALSE | 3.87
 | DC 0-25V Voltage Sensor |  | 1 | 3 | 3 | Hier Klicken (https://de.aliexpress.com/item/1005005993496290.html) | 0.98 € | 2.94 € | TRUE | TRUE | FALSE | 2.94
 |  |  | 0 | 0 | 0 |  |  | 0.00 € | FALSE | FALSE | FALSE | 0
 |  |  | 0 | 0 | 0 |  |  | 0.00 € | FALSE | FALSE | FALSE | 0
 |  |  | 0 | 0 | 0 |  |  | 0.00 € | FALSE | FALSE | FALSE | 0
 |  |  | 0 | 0 | 0 |  |  | 0.00 € | FALSE | FALSE | FALSE | 0
Kabel und Stecker | JST XH2.54 Stecker | JST Kit 2/3/4/5/6 Pin Stecker männlich und weiblich | 20 | 1 | 20 | Hier Klicken (https://de.aliexpress.com/item/1005003771221619.html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) |  | 0.00 € | FALSE | FALSE | FALSE | 0
 | USB 3.0 Verlängerungskabel 0.2m | USB 3.0 Verlängerungskabel männlich--weiblich 20cm | 1 | 1 | 1 | Hier Klicken (https://de.aliexpress.com/item/1005003245431542.html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) | 2.79 € | 2.79 € | FALSE | FALSE | FALSE | 0
 | U.FL zu RP-SMA Buchsenkabel | 20cm Koaxial Pigtail Kabel | 2 | 1 | 2 | Hier Klicken (https://amzn.eu/d/6e3xkHc) | 7.29 € | 7.29 € | FALSE | FALSE | FALSE | 0
 | 22AWG 0,35mm^2 Silikon Kabel | 6 Farben 8 Meter | 1 | 1 | 1 | Hier Klicken (https://amzn.eu/d/hDX6v4i) | 21.98 | 21.98 € | TRUE | TRUE | FALSE | 21.98
Mechanik | 3mm Kugellager | MR63ZZ Miniatur-Kugellager 3x6x2,5mm 9g | 10 | 1 | 10 | Hier Klicken (https://www.amazon.de/gp/product/B078RFDJXP/ref=ewc_pr_img_4?smid=AUWJSTRS7M679&psc=1) | 6.09 € | 6.09 € | TRUE | TRUE | TRUE | 0
 | 15mm Kugellager | 6802rs Kugellager 15x24x5mm | 10 | 1 | 10 | Hier Klicken (https://de.aliexpress.com/item/1005006138243978.html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) | 5.69 € | 5.69 € | TRUE | TRUE | TRUE | 0
 | 25T Servoarm 1,75 Zoll | Aluminium Servoarm 44,5/48/32mm | 1 | 4 | 4 | Hier Klicken (https://de.aliexpress.com/item/1005005970183727.html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) | 3.39 € | 13.56 € | FALSE | FALSE | FALSE | 0
 | 12mm Kugellager | MR128-2RS 8x12x3,5 | 10 | 1 | 10 | Hier Klicken (https://amzn.eu/d/8p5CojG) | 9.99 € | 9.99 € | TRUE | FALSE | FALSE | 9.99
 | M3 s Gewindeeinsätze | kurze M3 Gewindeeinsätze für 3d-Drucke | 100 | 1 | 100 | Hier Klicken (https://amzn.eu/d/hGrtDF3) | 8.99 € | 8.99 € | TRUE | FALSE | FALSE | 8.99
 | M1.2/M1.4/M2 Flachkopfschrauben |  | 500 | 1 | 500 | Hier Klicken (https://amzn.eu/d/dwozK4e) | 10.00 € | 10.00 € | TRUE | TRUE | FALSE | 10
 | M2 Gewindeeinsätze 50 Stück |  | 50 | 1 | 50 | Hier Klicken (https://amzn.eu/d/4uXsyhg) | 9.98 € | 9.98 € | TRUE | TRUE | FALSE | 9.98
 | M4 Schraubensatz |  | 1 | 1 | 1 | Hier Klicken (https://amzn.eu/d/2vz63Zu) | 15.87 € | 15.87 € | TRUE | TRUE | FALSE | 15.87
 | M4 Gewindeeinsätze 50 Stück |  | 50 | 1 | 50 | Hier Klicken (https://de.aliexpress.com/item/1005003582355741.html) | 2.19 € | 2.19 € | TRUE | TRUE | FALSE | 2.19
 | Metall Servo Arm Rund 25T |  | 5 | 1 | 5 | Hier Klicken (https://de.aliexpress.com/item/1005007481046296.html) | 3.17 € | 3.17 € | TRUE | TRUE | FALSE | 3.17
 |  |  |  |  | 0 |  |  | 0.00 € | FALSE | FALSE | FALSE | 0
3D-Druck Filament und Kunststoffe | SUNLU PLA+2.0 Filament Grau |  | 2 | 1 | 2 | Hier Klicken (https://amzn.eu/d/5tCygkL) | 36.99 € | 36.99 € | TRUE | FALSE | FALSE | 36.99
 |  |  |  |  | 0 |  |  | 0.00 € | FALSE | FALSE | FALSE | 0
 |  |  |  |  | 0 |  |  |  | FALSE | FALSE | FALSE | 0
 |  |  |  |  | 0 |  |  |  | FALSE | FALSE | FALSE | 0
 |  |  |  |  | 0 |  |  |  | FALSE | FALSE | FALSE | 0
 |  |  |  |  | 0 |  |  |  | FALSE | FALSE | FALSE | 0
 |  |  |  |  | 0 |  |  |  | FALSE | FALSE | FALSE | 0
 |  |  |  |  | 0 |  |  |  | FALSE | FALSE | FALSE | 0
 |  |  |  |  | 0 |  |  |  | FALSE | FALSE | FALSE | 0
 |  |  |  |  | 843 |  |  | 797.78 € |  |  |  | 704.87 | 35.19 €
