jacobutermoehlen/SCOUT_RobotDog/3DParts/Assem1.SLDASM

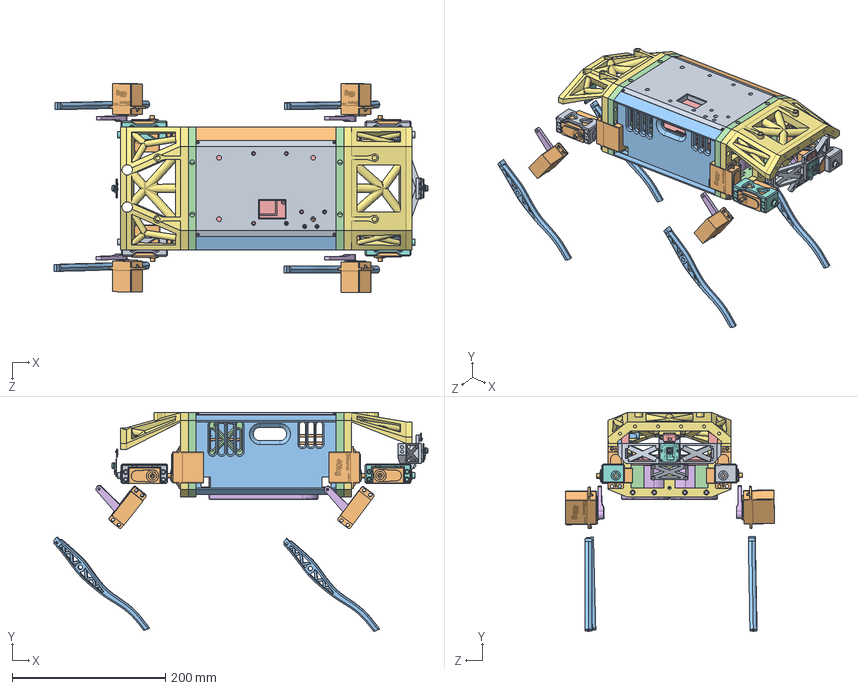
[picture p61: CAD file, 2026-10-05]
3DParts/Assem1.SLDASM
487.4 x 285.5 x 272.6 mm
LowerLeg x 4
QY3240MG(40kg) x 12
UpperLegServoMount x 2
UpperLegServoMountMirror x 2
BackConnectorPlate
LowerLeg_LeverArm x 4
PCA9685_Carrier
PCA9685 x 2
PowerDistroBoard_12x
FrontSensorCarrier
RPI-CAM-V2 x 2
FrontConnectorPlate
LiPo5Ah6s x 2
vl53l0x-V2 x 2
BodyEnd x 2
SidePanel_Closed
SidePanel_ClosedLeft
