jacobutermoehlen/SCOUT_RobotDog/3DParts/FootMold/MoldAssembly.SLDASM

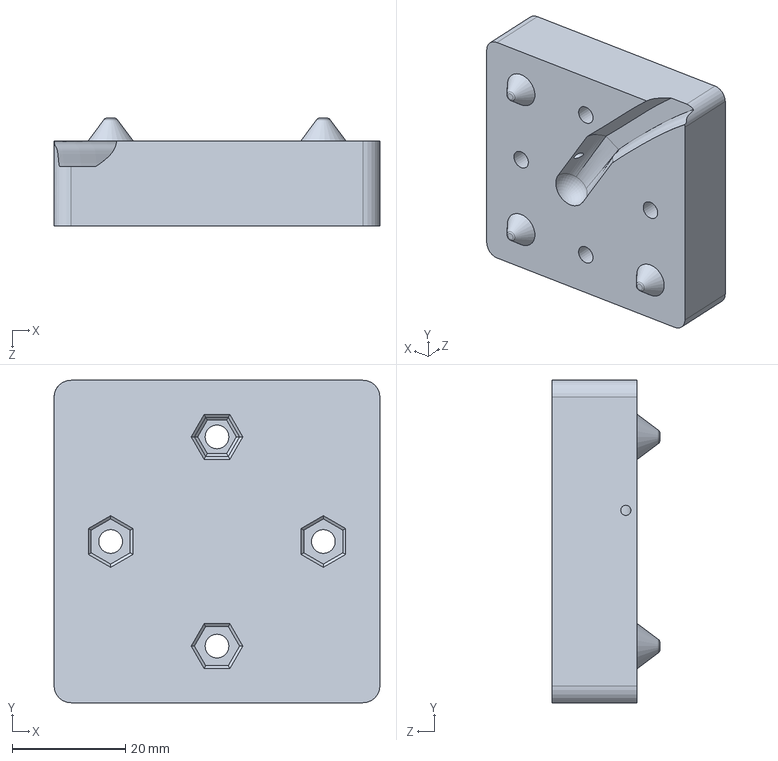
[picture p62: CAD file, 2025-02-19]
3DParts/FootMold/MoldAssembly.SLDASM
57.5 x 56.9 x 19.0 mm
