jacobutermoehlen/SCOUT_RobotDog/3DParts/Body/BodyAssembly1.SLDASM

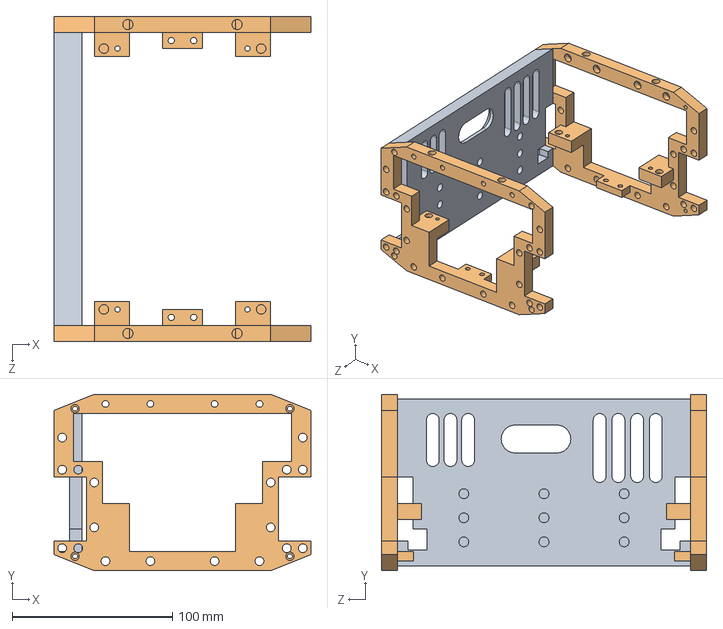
[picture p63: CAD file, 2024-12-27]
3DParts/Body/BodyAssembly1.SLDASM
160.0 x 110.0 x 202.6 mm
BodyEnd x 2
SidePanel_Closed
