jacobutermoehlen/SCOUT_RobotDog/ElektronicParts/PowerDistro/DistroAssembly.SLDASM

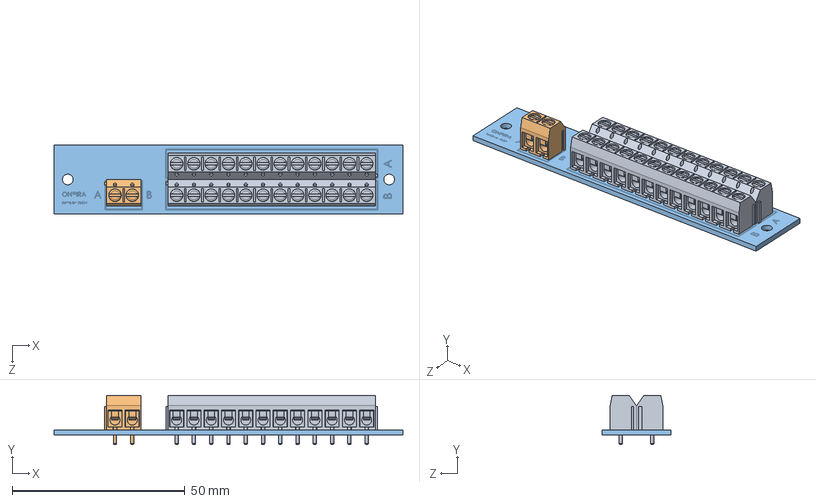
[picture p64: CAD file, 2024-12-27]
ElektronicParts/PowerDistro/DistroAssembly.SLDASM
101.0 x 14.3 x 20.0 mm
12xPowerDistroBoard
DG301-5.0-02
DG301-5.0-12 x 2
