jacobutermoehlen/SCOUT_RobotDog/3DParts/KinematicAssembly.SLDASM

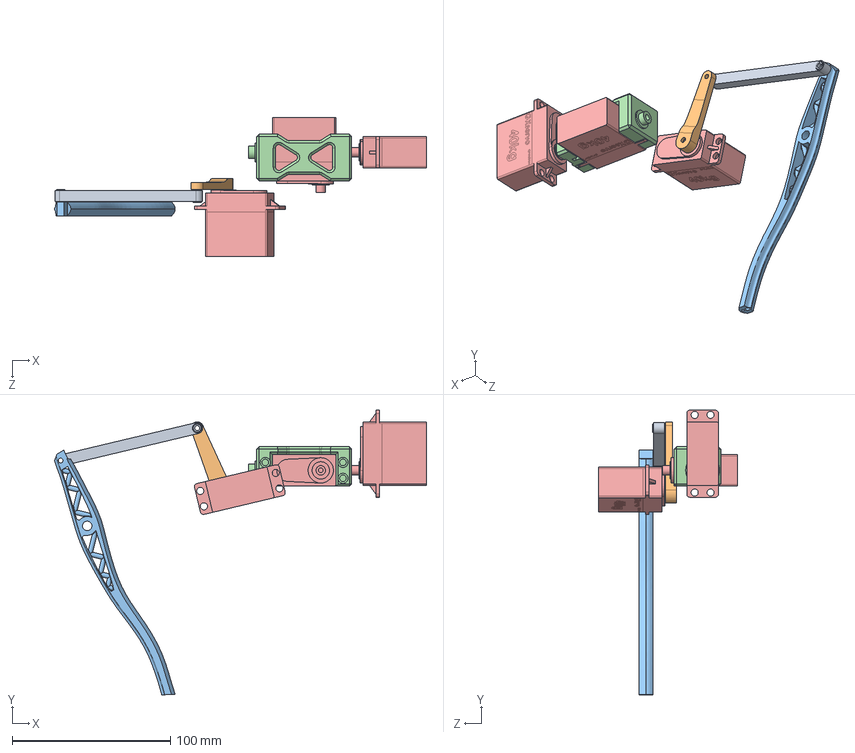
[picture p65: CAD file, 2025-02-19]
3DParts/KinematicAssembly.SLDASM
234.7 x 179.7 x 87.7 mm
QY3240MG(40kg) x 3
UpperLegServoMount
LowerLeg
LowerLeg_LeverArm
LowerLeg_PushRodTest
