jacobutermoehlen/SCOUT_RobotDog/3DParts/Body/BodyEnd.SLDPRT

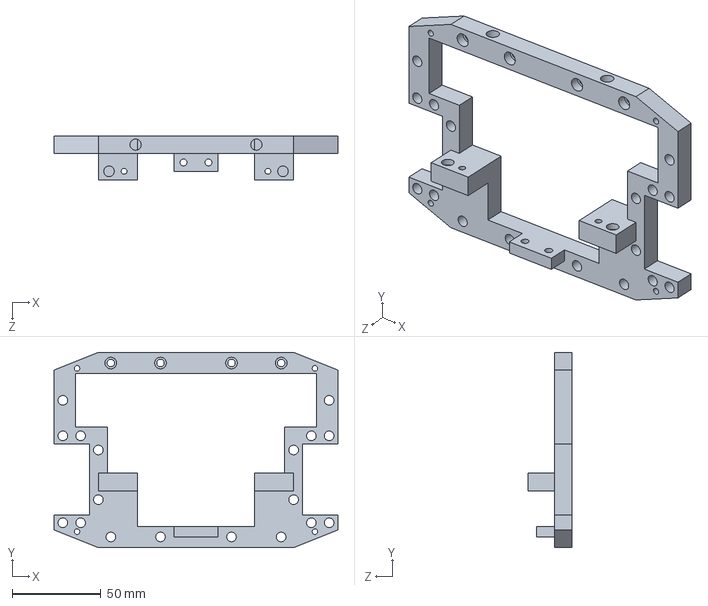
[picture p66: CAD file, 2024-12-27]
3DParts/Body/BodyEnd.SLDPRT
160.0 x 110.0 x 25.0 mm
