jacobutermoehlen/SCOUT_RobotDog/3DParts/ElectronicsCage/StandoffBlock.SLDPRT

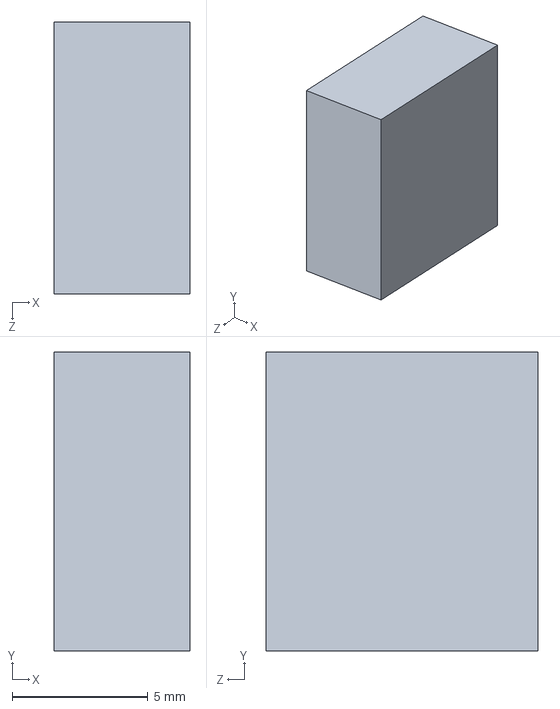
[picture p67: CAD file, 2025-02-19]
3DParts/ElectronicsCage/StandoffBlock.SLDPRT
5.00 x 11.0 x 10.0 mm
