jacobutermoehlen/SCOUT_RobotDog/3DParts/FrontElectronicsCarrier/FrontSensorCarrier.SLDPRT

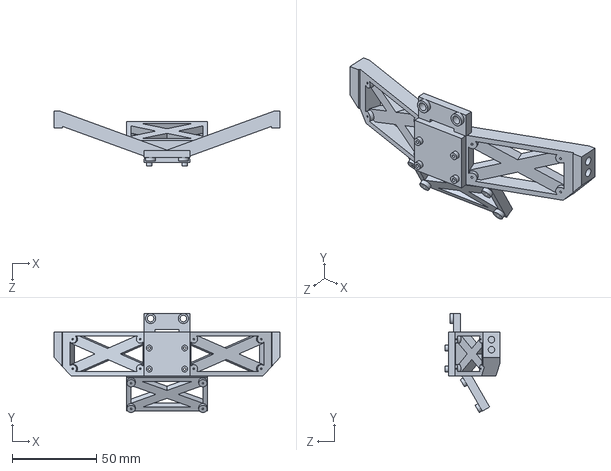
[picture p68: CAD file, 2024-12-27]
3DParts/FrontElectronicsCarrier/FrontSensorCarrier.SLDPRT
134.0 x 58.8 x 32.5 mm
