jacobutermoehlen/SCOUT_RobotDog/3DParts/LegTeststand/ServoMount.SLDPRT

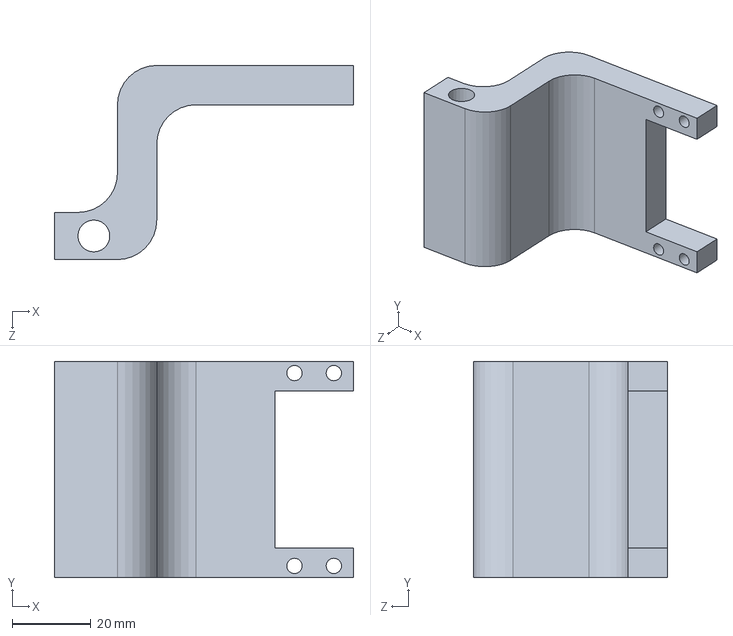
[picture p69: CAD file, 2024-12-27]
3DParts/LegTeststand/ServoMount.SLDPRT
76.0 x 55.0 x 49.4 mm
