jacobutermoehlen/SCOUT_RobotDog/Drawings/SidePanelTest.STEP

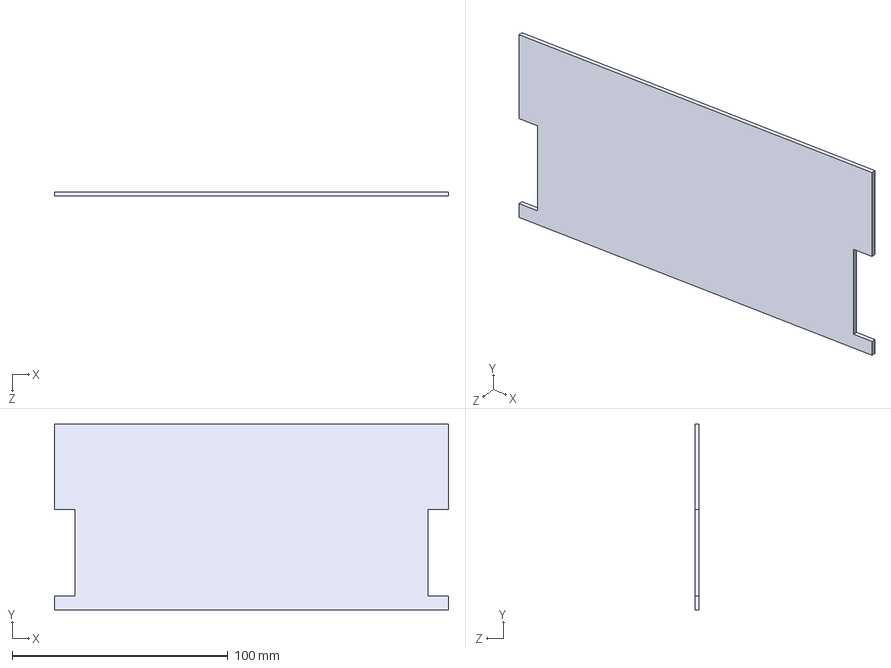
[picture p70: CAD file, 2024-12-27]
Drawings/SidePanelTest.STEP
182.6 x 86.0 x 2.00 mm
