jacobutermoehlen/SCOUT_RobotDog/ElektronicParts/PCA9685.SLDPRT

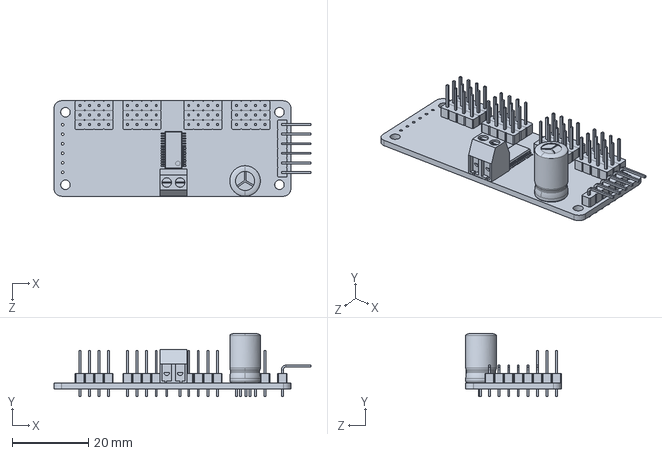
[picture p71: CAD file, 2025-02-19]
ElektronicParts/PCA9685.SLDPRT
67.2 x 16.5 x 25.0 mm
