jacobutermoehlen/SCOUT_RobotDog/ElektronicParts/PowerDistro/DG301-5.0-12.SLDPRT

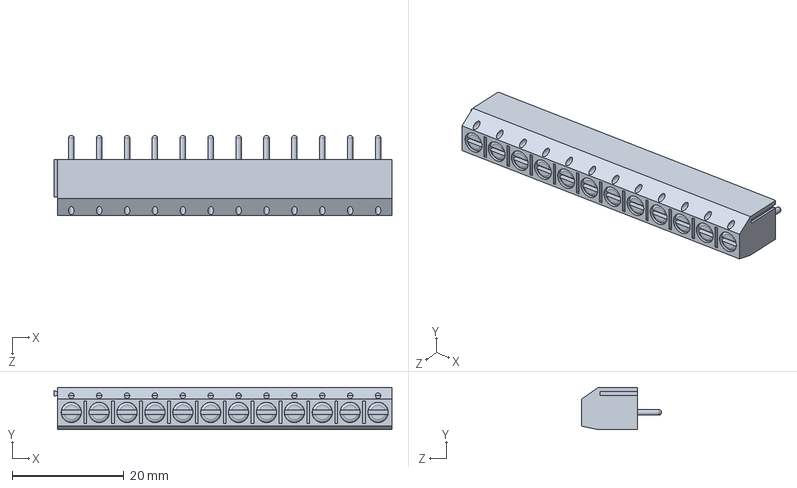
[picture p72: CAD file, 2024-12-27]
ElektronicParts/PowerDistro/DG301-5.0-12.SLDPRT
60.6 x 7.60 x 14.3 mm
