jacobutermoehlen/SCOUT_RobotDog/IdeaDevelopment/OutlinesV1.SLDPRT

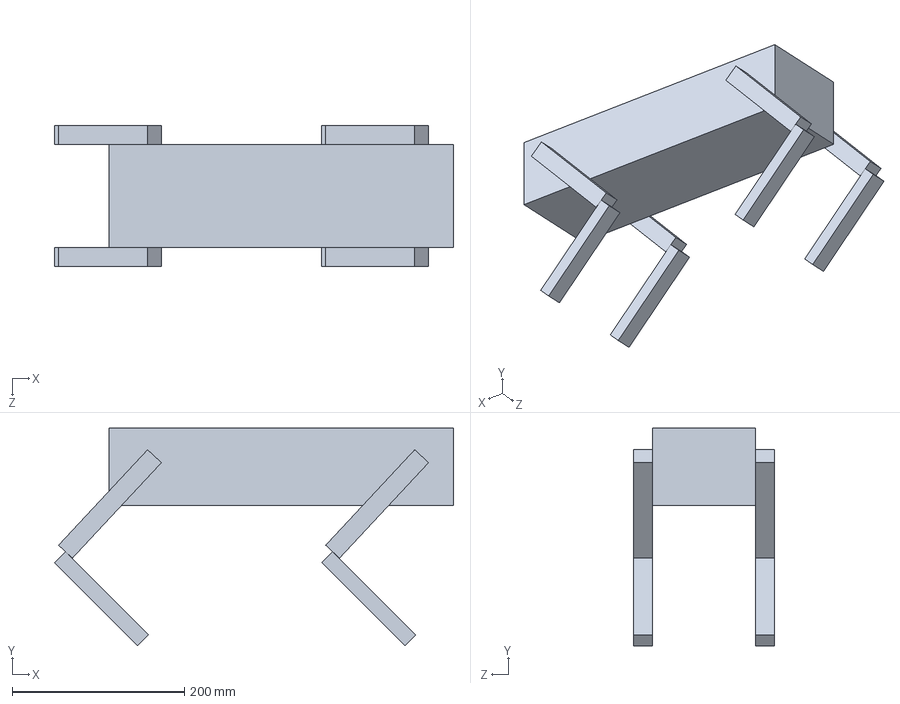
[picture p73: CAD file, 2024-12-27]
IdeaDevelopment/OutlinesV1.SLDPRT
463.0 x 252.6 x 164.0 mm
