jacobutermoehlen/SCOUT_RobotDog/3DParts/ElectronicsCage/UltrasonicSensorCarrier.SLDPRT

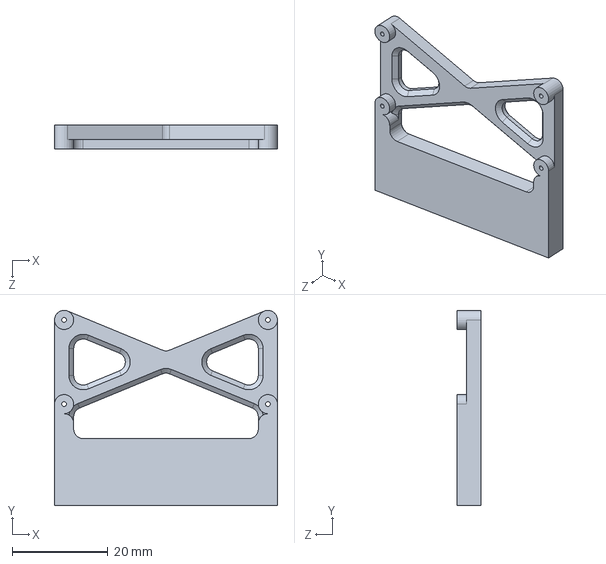
[picture p74: CAD file, 2025-02-19]
3DParts/ElectronicsCage/UltrasonicSensorCarrier.SLDPRT
46.6 x 40.8 x 5.00 mm
