jacobutermoehlen/SCOUT_RobotDog/3DParts/FootMold/MoldPart2.SLDPRT

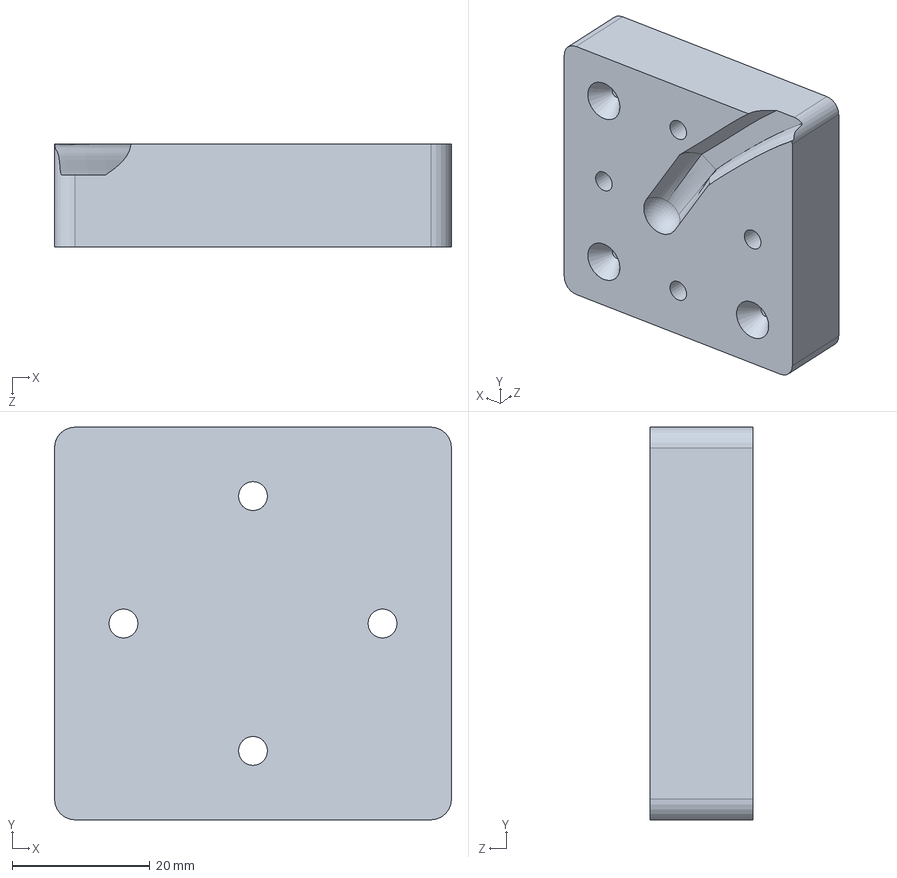
[picture p75: CAD file, 2025-02-19]
3DParts/FootMold/MoldPart2.SLDPRT
57.5 x 56.9 x 15.0 mm
