jacobutermoehlen/SCOUT_RobotDog/3DParts/LegTeststand/Base.SLDPRT

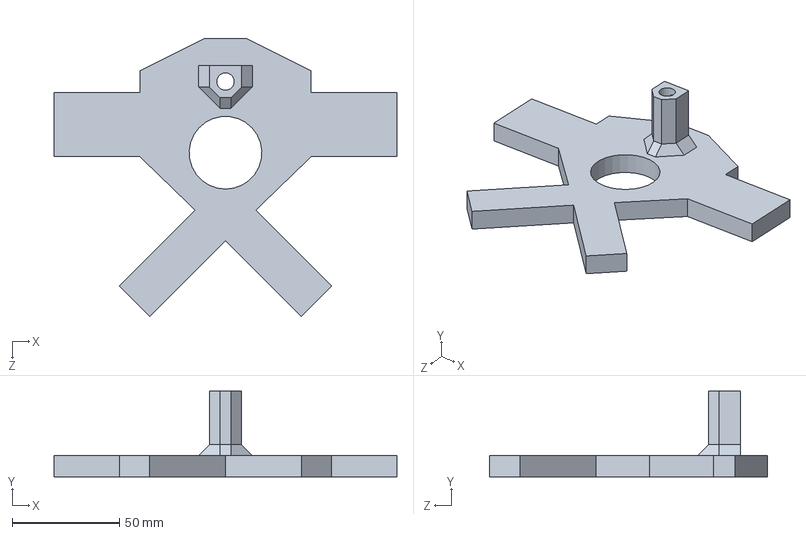
[picture p76: CAD file, 2024-12-27]
3DParts/LegTeststand/Base.SLDPRT
160.0 x 40.0 x 129.5 mm
