jacobutermoehlen/SCOUT_RobotDog/3DParts/Stand_QuickRelease.SLDPRT

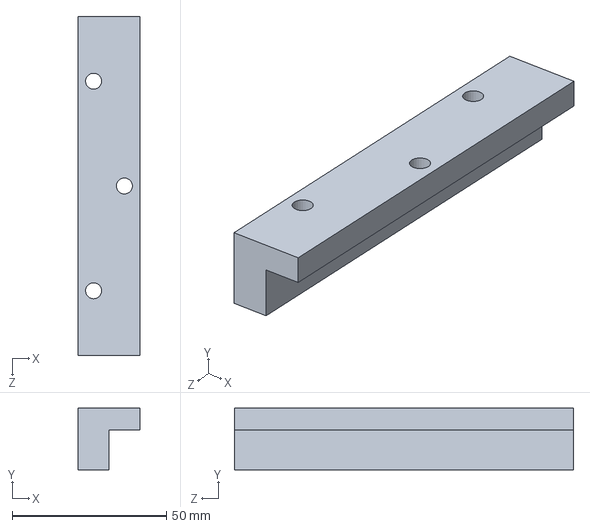
[picture p77: CAD file, 2025-02-19]
3DParts/Stand_QuickRelease.SLDPRT
20.0 x 20.0 x 110.0 mm
