jacobutermoehlen/SCOUT_RobotDog/ElektronicParts/PowerDistro/12xPowerDistroBoard.SLDPRT

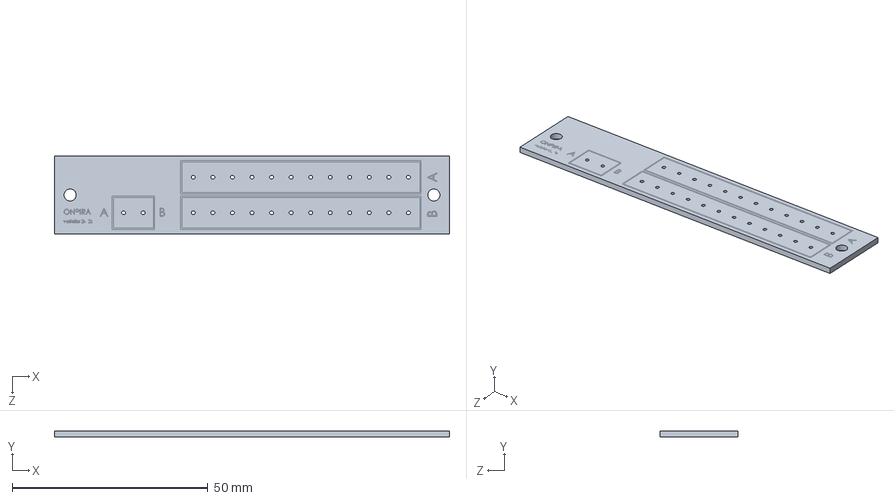
[picture p78: CAD file, 2024-12-27]
ElektronicParts/PowerDistro/12xPowerDistroBoard.SLDPRT
101.0 x 1.55 x 20.0 mm
