jacobutermoehlen/SCOUT_RobotDog/ElektronicParts/QY3240MG(40kg).SLDPRT

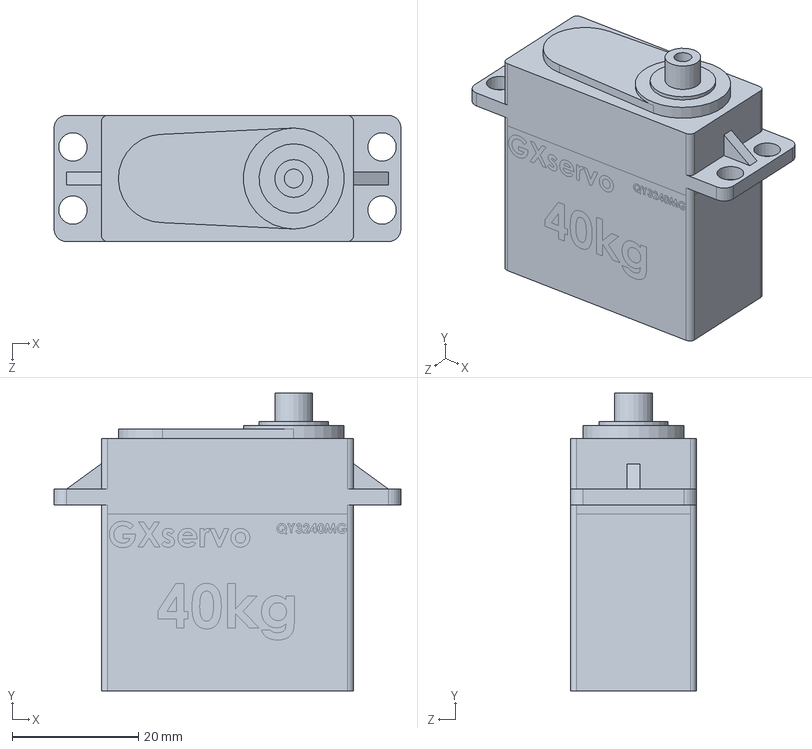
[picture p79: CAD file, 2025-02-19]
ElektronicParts/QY3240MG(40kg).SLDPRT
55.0 x 47.2 x 20.0 mm
