jacobutermoehlen/SCOUT_RobotDog/3DParts/Body/SidePanel_ClosedLeft.SLDPRT

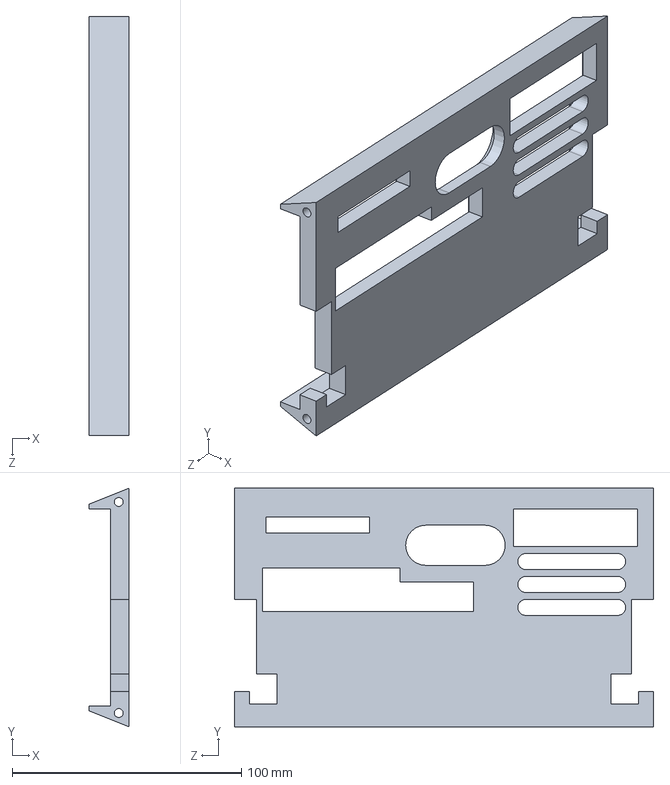
[picture p80: CAD file, 2024-12-27]
3DParts/Body/SidePanel_ClosedLeft.SLDPRT
17.5 x 104.0 x 182.6 mm
