jacobutermoehlen/SCOUT_RobotDog/3DParts/ElectronicsCage/Part1.SLDPRT

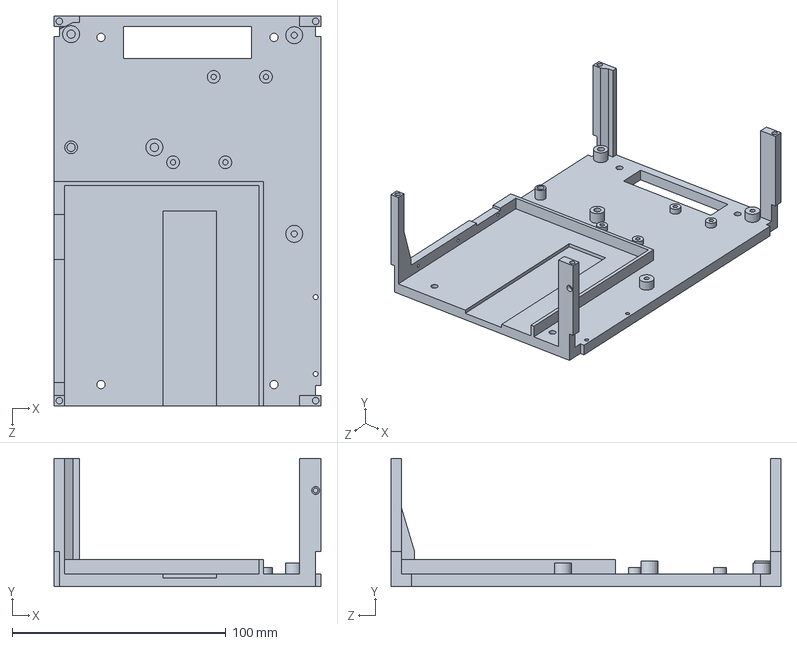
[picture p81: CAD file, 2024-12-27]
3DParts/ElectronicsCage/Part1.SLDPRT
125.0 x 60.0 x 182.6 mm
