jacobutermoehlen/SCOUT_RobotDog/3DParts/LowerLeg.SLDPRT

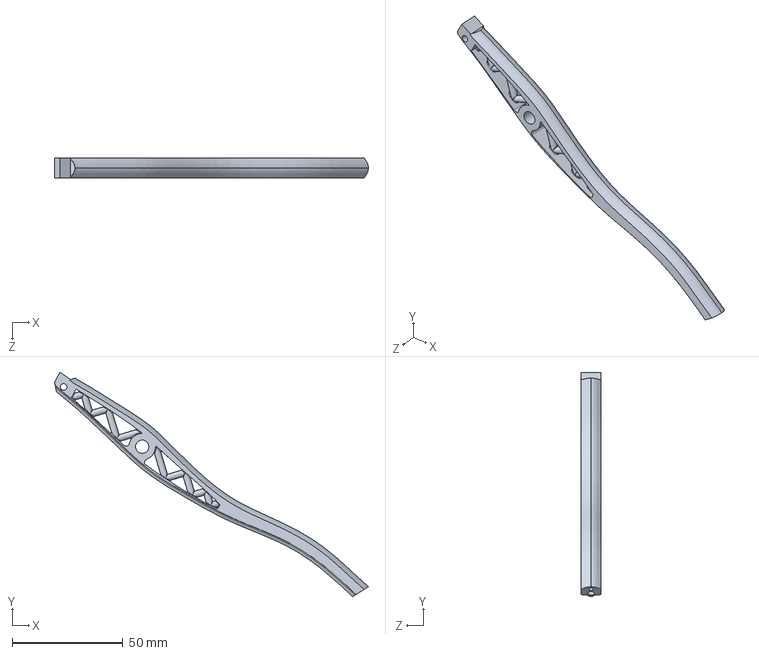
[picture p82: CAD file, 2025-02-19]
3DParts/LowerLeg.SLDPRT
141.6 x 101.2 x 9.00 mm
