jacobutermoehlen/SCOUT_RobotDog/ElektronicParts/PowerDistro/DG301-5.0-02.SLDPRT

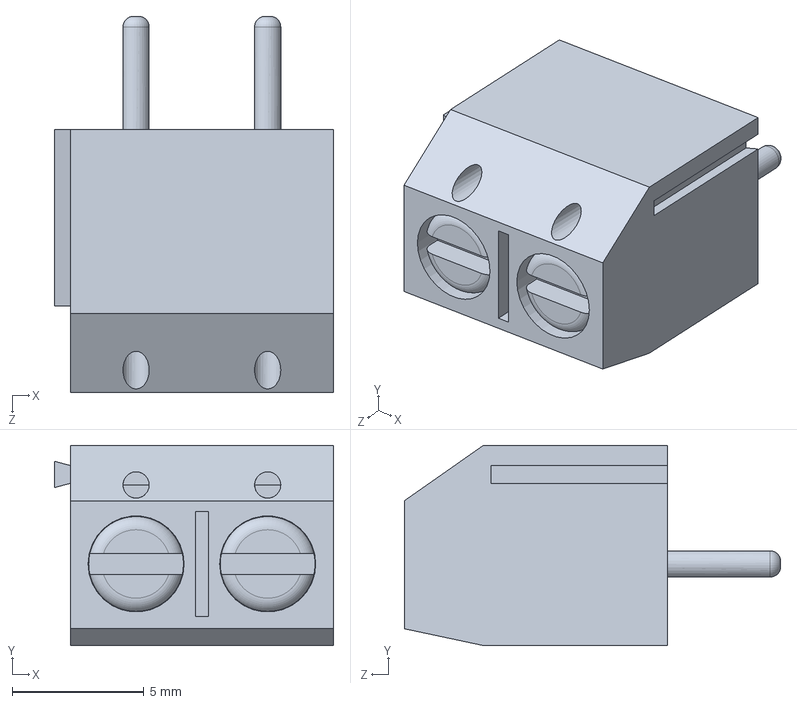
[picture p83: CAD file, 2024-12-27]
ElektronicParts/PowerDistro/DG301-5.0-02.SLDPRT
10.6 x 7.60 x 14.3 mm
