jacobutermoehlen/SCOUT_RobotDog/ElektronicParts/RPI-CAM-V2.SLDPRT

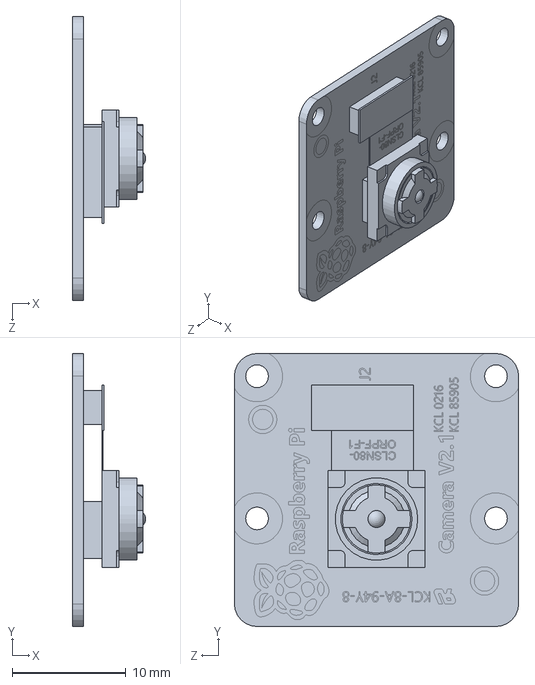
[picture p84: CAD file, 2024-12-27]
ElektronicParts/RPI-CAM-V2.SLDPRT
6.45 x 24.0 x 25.0 mm
