jacobutermoehlen/SCOUT_RobotDog/3DParts/ElectronicsCage/FanHolderSide.SLDPRT

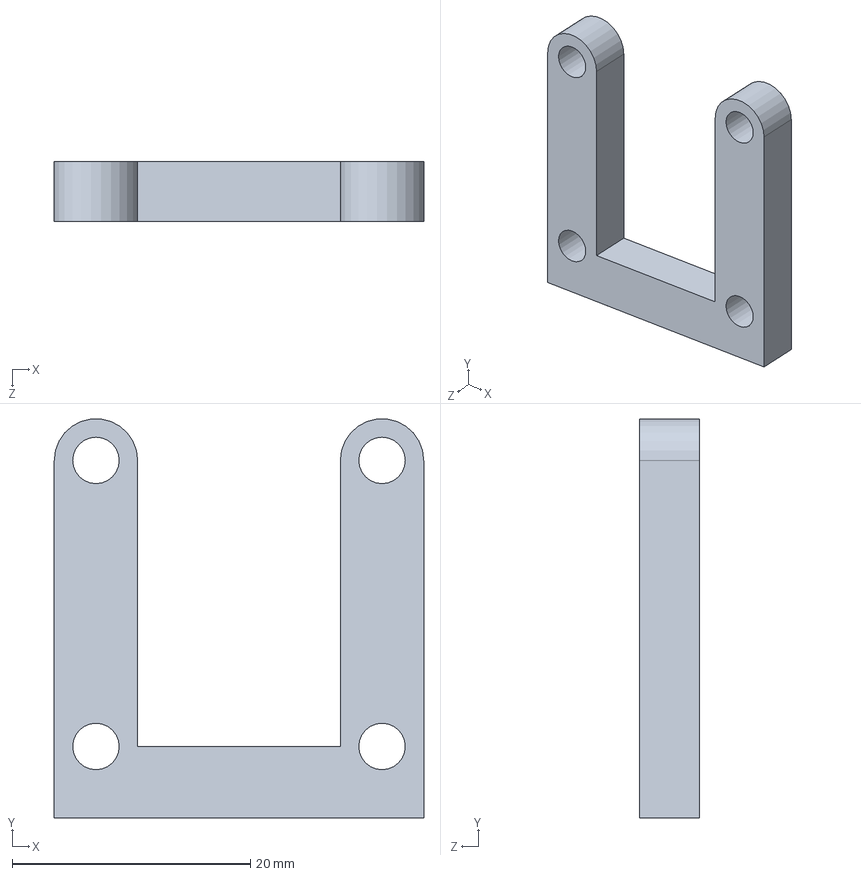
[picture p86: CAD file, 2024-12-27]
3DParts/ElectronicsCage/FanHolderSide.SLDPRT
31.0 x 33.5 x 5.00 mm
