jacobutermoehlen/SCOUT_RobotDog/3DParts/UpperLegServoMount.SLDPRT

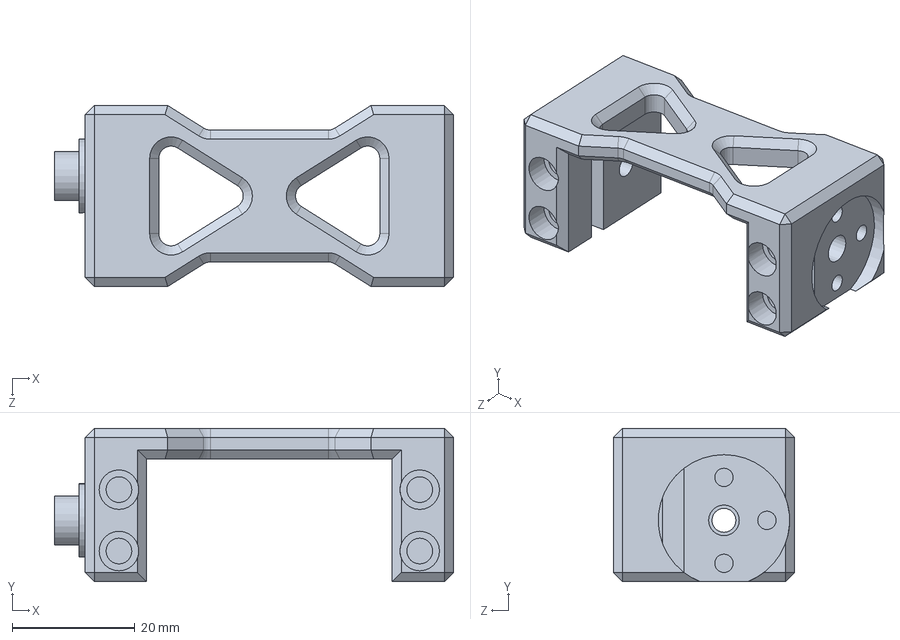
[picture p87: CAD file, 2025-02-19]
3DParts/UpperLegServoMount.SLDPRT
65.0 x 25.0 x 29.5 mm
