jacobutermoehlen/SCOUT_RobotDog/3DParts/ElectronicsCage/PCA9685_Carrier.SLDPRT

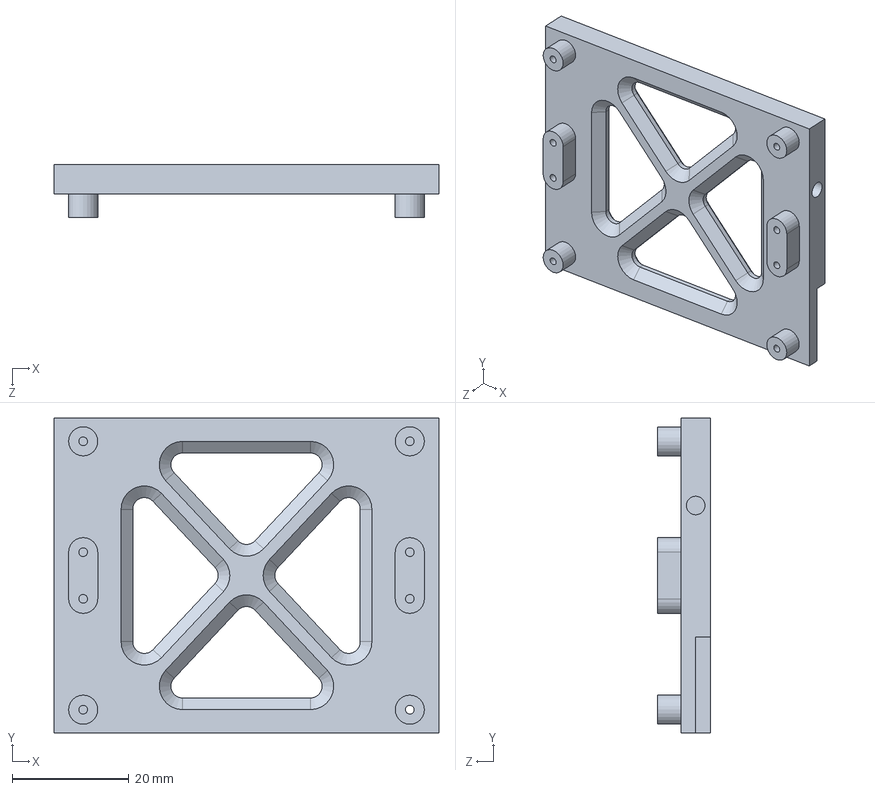
[picture p88: CAD file, 2024-12-27]
3DParts/ElectronicsCage/PCA9685_Carrier.SLDPRT
66.0 x 54.0 x 9.00 mm
