jacobutermoehlen/SCOUT_RobotDog/3DParts/Stand_Arm_quick.SLDPRT

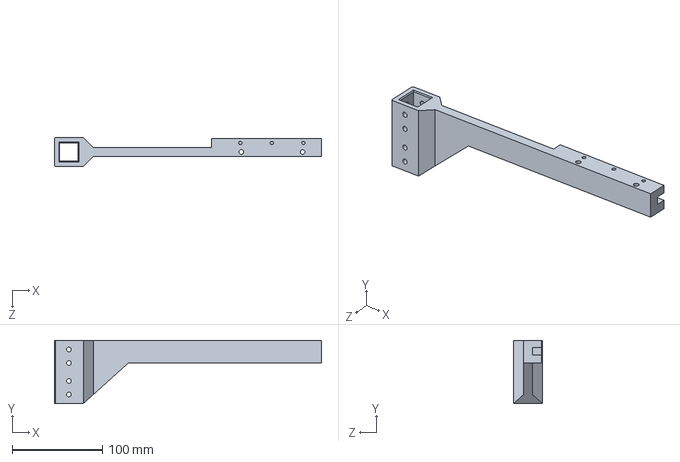
[picture p89: CAD file, 2025-02-19]
3DParts/Stand_Arm_quick.SLDPRT
296.2 x 70.0 x 32.0 mm
