jacobutermoehlen/SCOUT_RobotDog/ElektronicParts/LiPo5Ah6s.SLDPRT

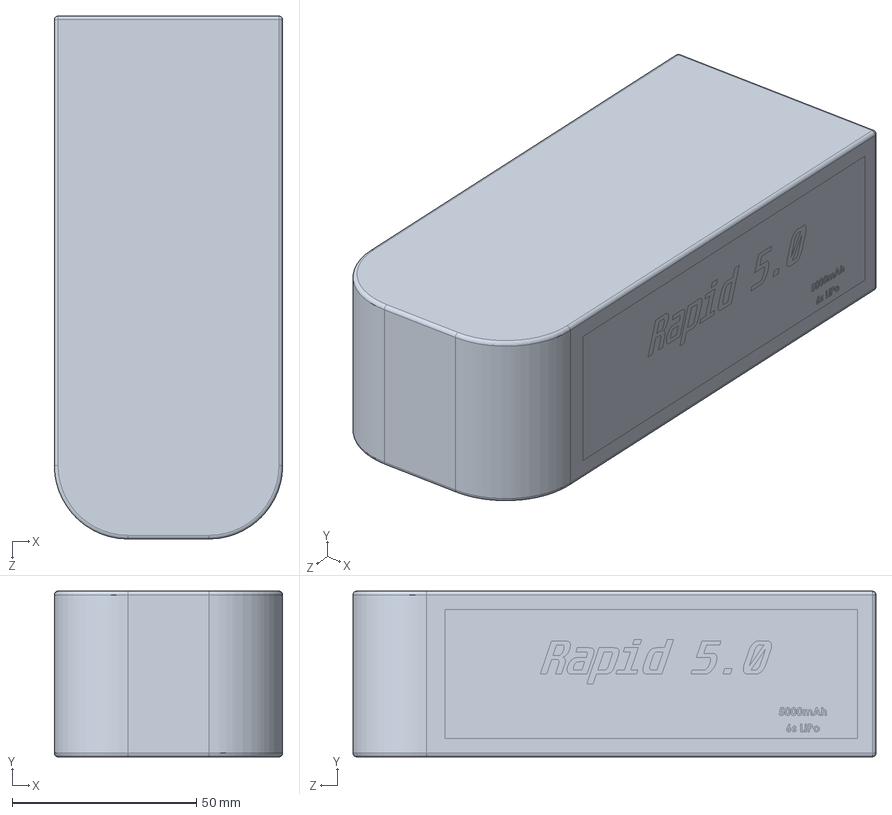
[picture p90: CAD file, 2024-12-27]
ElektronicParts/LiPo5Ah6s.SLDPRT
62.0 x 45.0 x 142.0 mm
