jacobutermoehlen/SCOUT_RobotDog/3DParts/ElectronicsCage/Part2.SLDPRT

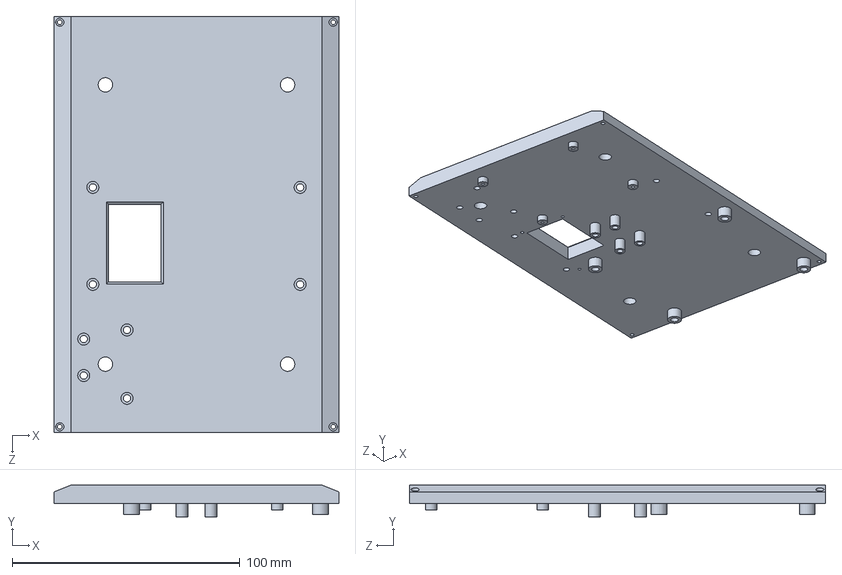
[picture p91: CAD file, 2024-12-27]
3DParts/ElectronicsCage/Part2.SLDPRT
125.0 x 14.0 x 182.6 mm
