jacobutermoehlen/SCOUT_RobotDog/3DParts/Stand_Arm.SLDPRT

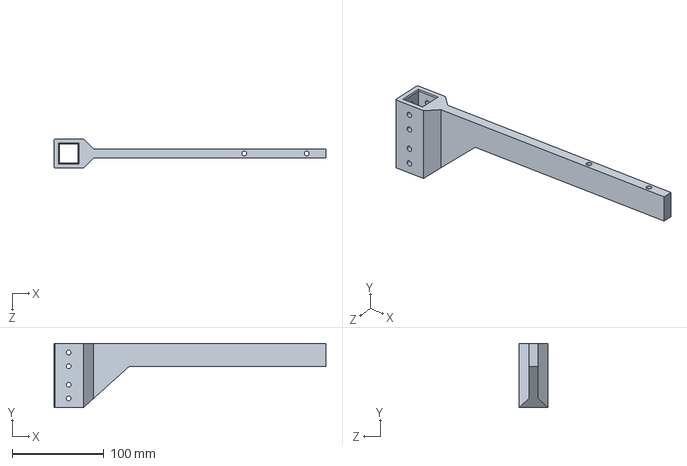
[picture p92: CAD file, 2025-02-19]
3DParts/Stand_Arm.SLDPRT
296.2 x 70.0 x 32.0 mm
