jacobutermoehlen/SCOUT_RobotDog/ElektronicParts/vl53l0x-V2.SLDPRT

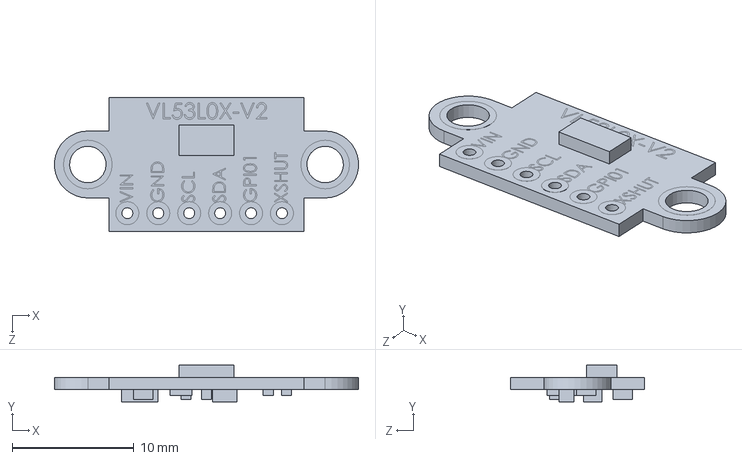
[picture p93: CAD file, 2024-12-27]
ElektronicParts/vl53l0x-V2.SLDPRT
25.0 x 3.00 x 11.0 mm
