jacobutermoehlen/SCOUT_RobotDog/3DParts/FlummiFoot.SLDPRT

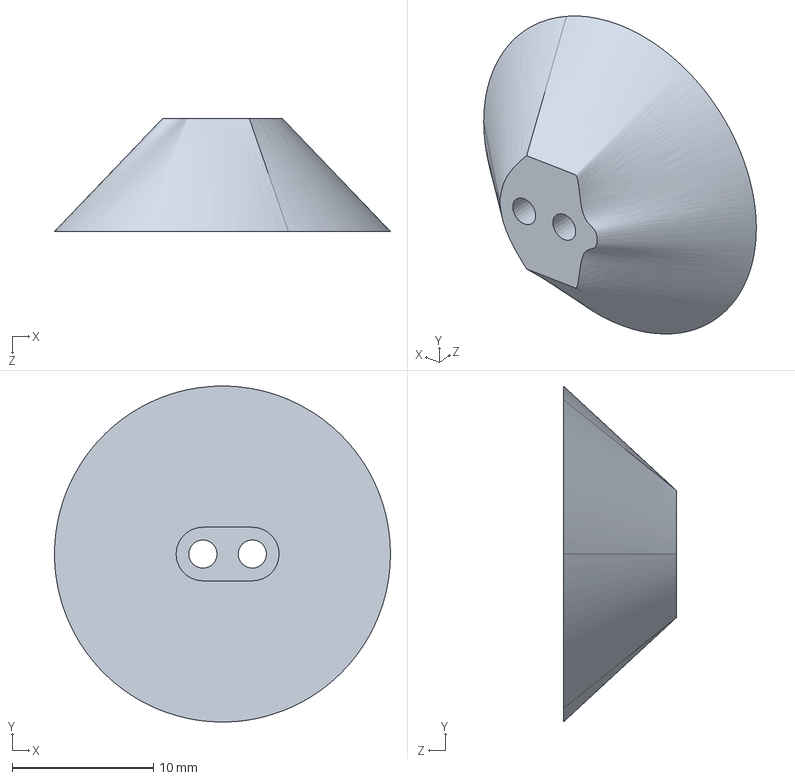
[picture p94: CAD file, 2025-02-19]
3DParts/FlummiFoot.SLDPRT
23.8 x 23.8 x 8.00 mm
