jacobutermoehlen/SCOUT_RobotDog/3DParts/UpperLegServoMountMirror.SLDPRT

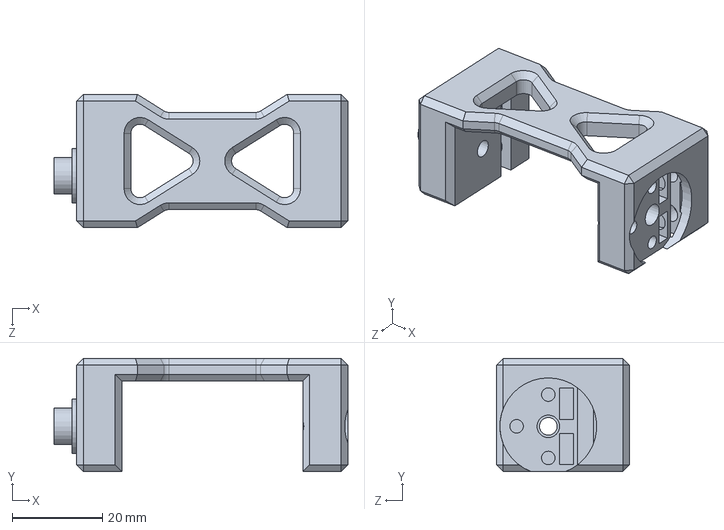
[picture p95: CAD file, 2025-02-19]
3DParts/UpperLegServoMountMirror.SLDPRT
65.0 x 25.0 x 29.5 mm
