jacobutermoehlen/SCOUT_RobotDog/3DParts/LowerLeg_PushRodTest.SLDPRT

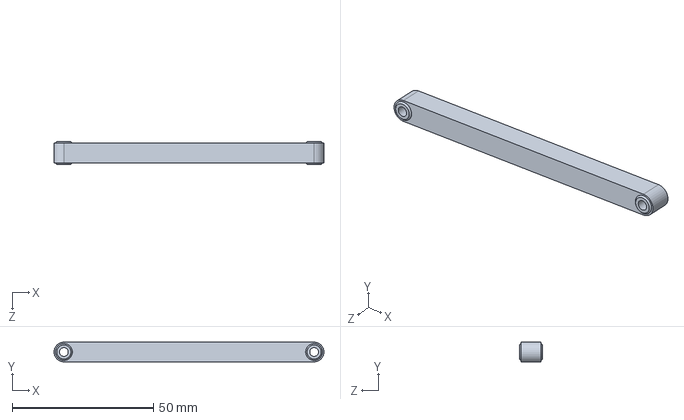
[picture p96: CAD file, 2025-02-19]
3DParts/LowerLeg_PushRodTest.SLDPRT
95.5 x 7.00 x 8.10 mm
