jacobutermoehlen/SCOUT_RobotDog/3DParts/FrontConnectorPlate.SLDPRT

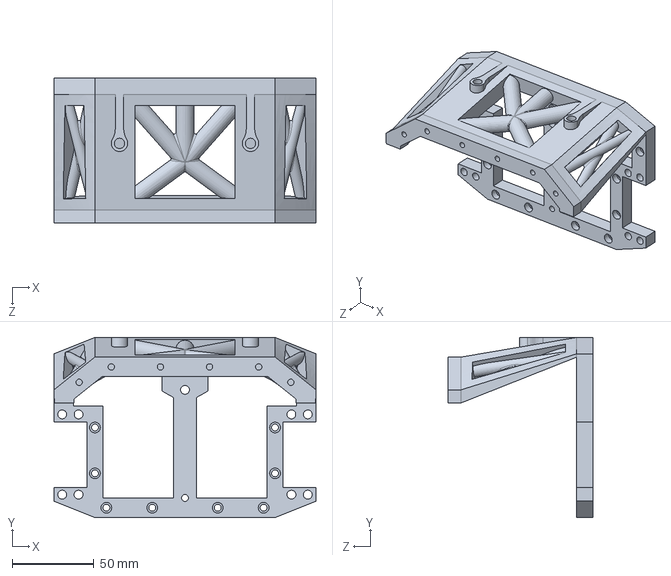
[picture p97: CAD file, 2025-02-19]
3DParts/FrontConnectorPlate.SLDPRT
160.0 x 110.0 x 88.7 mm
