jacobutermoehlen/SCOUT_RobotDog/3DParts/LowerLeg_MoldStub_solid.SLDPRT

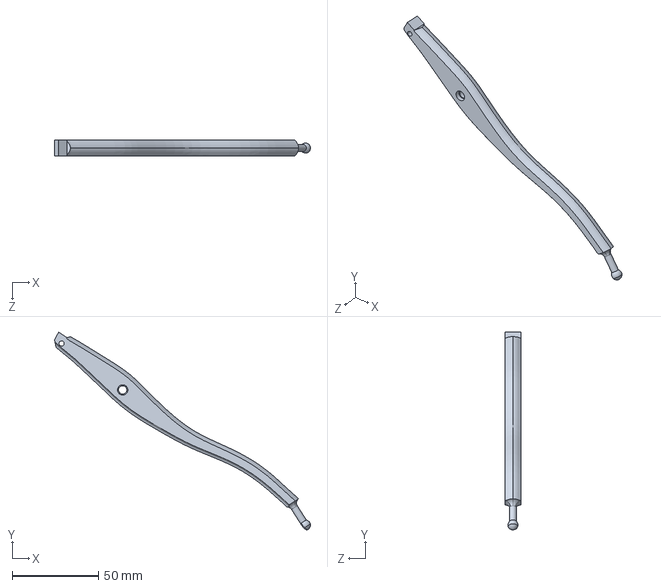
[picture p98: CAD file, 2025-02-19]
3DParts/LowerLeg_MoldStub_solid.SLDPRT
148.5 x 114.7 x 9.00 mm
