jacobutermoehlen/SCOUT_RobotDog/3DParts/LowerLeg_LeverArm.SLDPRT

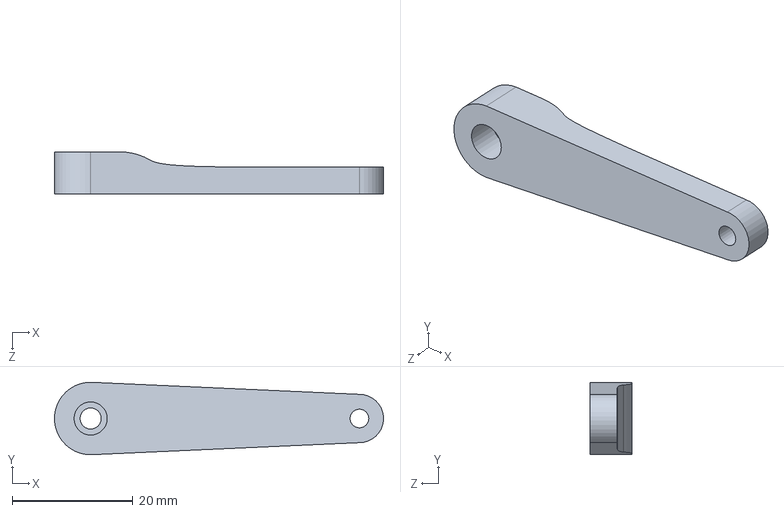
[picture p100: CAD file, 2025-02-19]
3DParts/LowerLeg_LeverArm.SLDPRT
54.5 x 12.0 x 7.00 mm
