jacobutermoehlen/SCOUT_RobotDog/3DParts/Stand_DeskClamp.SLDPRT

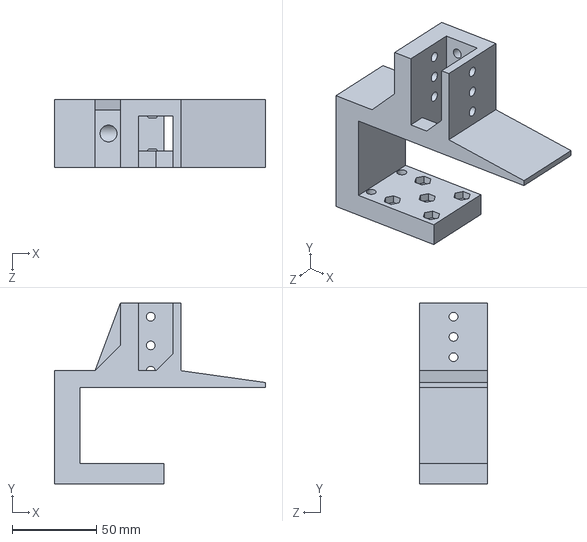
[picture p101: CAD file, 2025-02-19]
3DParts/Stand_DeskClamp.SLDPRT
125.0 x 107.0 x 40.0 mm
