jacobutermoehlen/SCOUT_RobotDog/3DParts/PlainFoot.SLDPRT

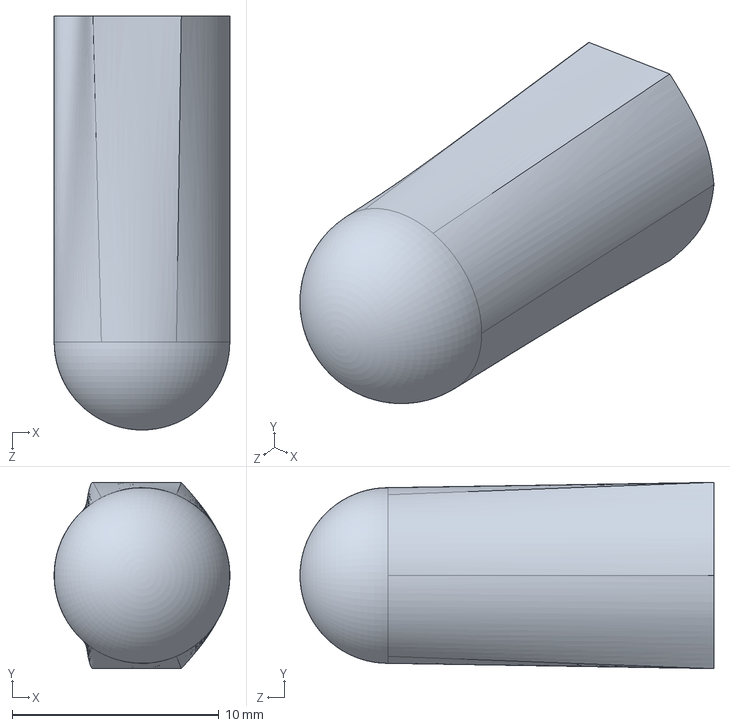
[picture p102: CAD file, 2025-02-19]
3DParts/PlainFoot.SLDPRT
8.49 x 9.00 x 20.0 mm
