jacobutermoehlen/SCOUT_RobotDog/3DParts/TestFootV1.SLDPRT

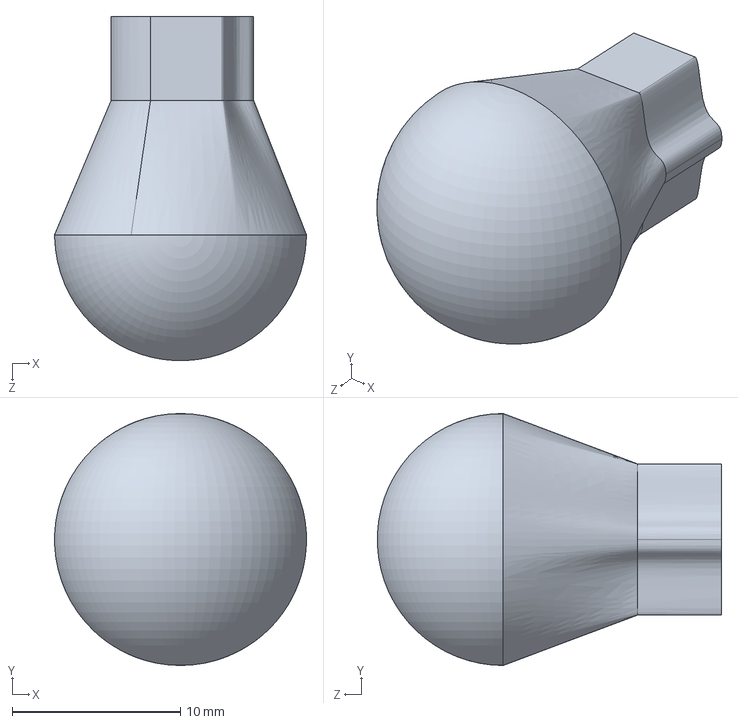
[picture p103: CAD file, 2024-12-27]
3DParts/TestFootV1.SLDPRT
15.0 x 15.0 x 20.5 mm
