jacobutermoehlen/SCOUT_RobotDog/3DParts/BackPlate.SLDPRT

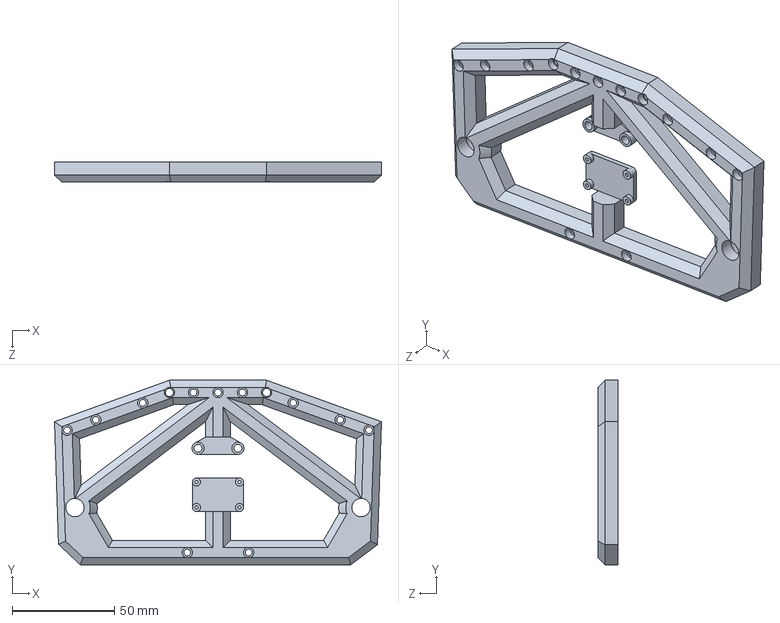
[picture p104: CAD file, 2024-12-27]
3DParts/BackPlate.SLDPRT
160.0 x 90.3 x 10.0 mm
