jacobutermoehlen/SCOUT_RobotDog/3DParts/BackStabeliser.SLDPRT

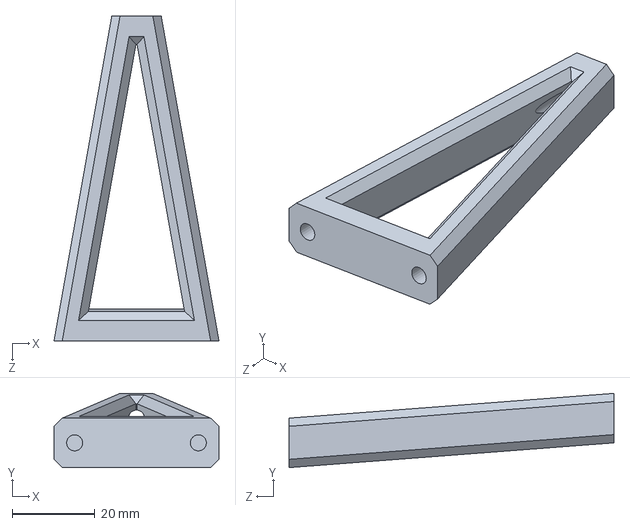
[picture p105: CAD file, 2024-12-27]
3DParts/BackStabeliser.SLDPRT
40.0 x 18.0 x 78.7 mm
