jacobutermoehlen/SCOUT_RobotDog/3DParts/FrontPlate.SLDPRT

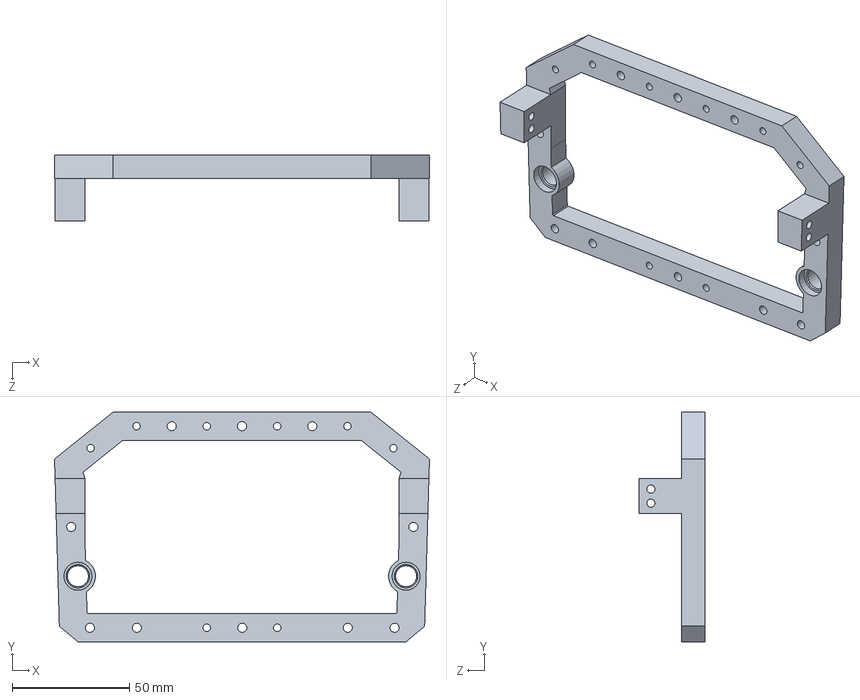
[picture p106: CAD file, 2024-12-27]
3DParts/FrontPlate.SLDPRT
160.0 x 98.0 x 28.0 mm
