jacobutermoehlen/SCOUT_RobotDog/3DParts/LowerLeg_PushRodSpring.SLDPRT

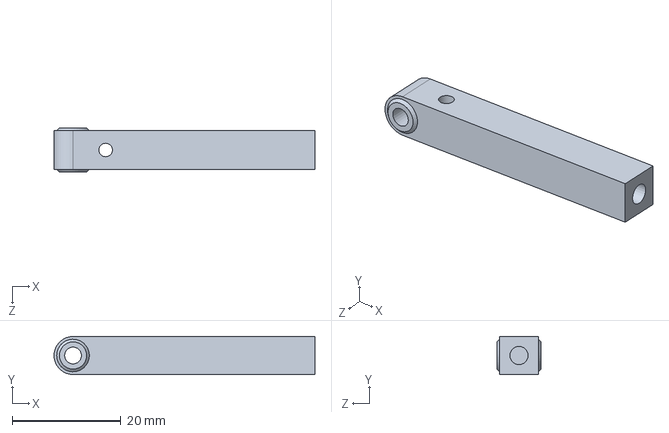
[picture p107: CAD file, 2024-12-27]
3DParts/LowerLeg_PushRodSpring.SLDPRT
48.0 x 7.00 x 8.10 mm
