jacobutermoehlen/SCOUT_RobotDog/3DParts/FrontConnectorPlate_wMount.SLDPRT

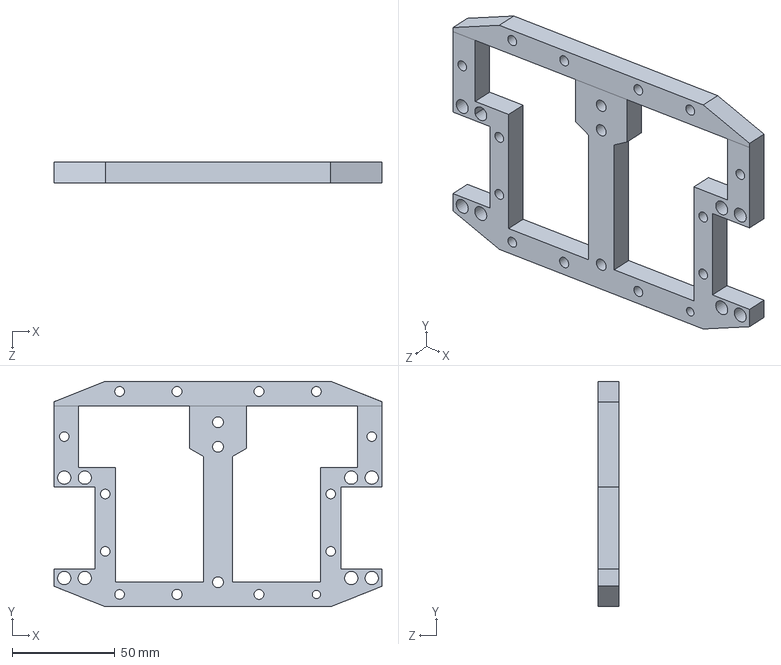
[picture p108: CAD file, 2024-12-27]
3DParts/FrontConnectorPlate_wMount.SLDPRT
160.0 x 110.0 x 10.0 mm
