jacobutermoehlen/SCOUT_RobotDog/3DParts/TestBody.SLDPRT

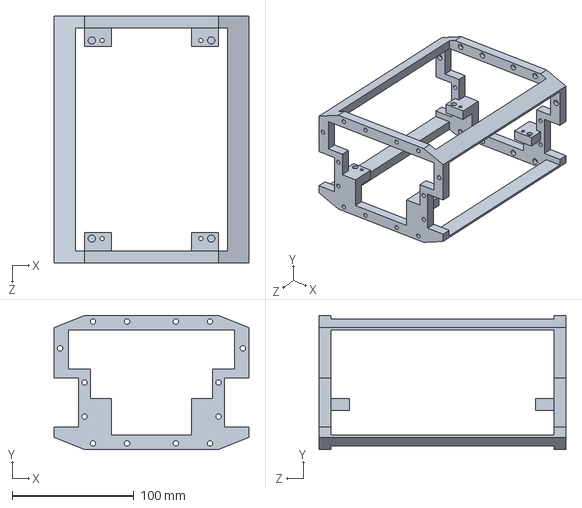
[picture p109: CAD file, 2024-12-27]
3DParts/TestBody.SLDPRT
160.0 x 110.0 x 202.6 mm
