jacobutermoehlen/SCOUT_RobotDog/3DParts/JetsonOrinNanoFanCover.SLDPRT

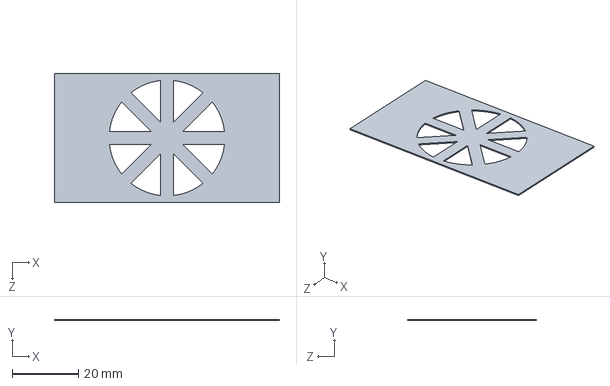
[picture p110: CAD file, 2024-12-27]
3DParts/JetsonOrinNanoFanCover.SLDPRT
68.0 x 0.4 x 39.0 mm
