jacobutermoehlen/SCOUT_RobotDog/3DParts/BatteryHolder.SLDPRT

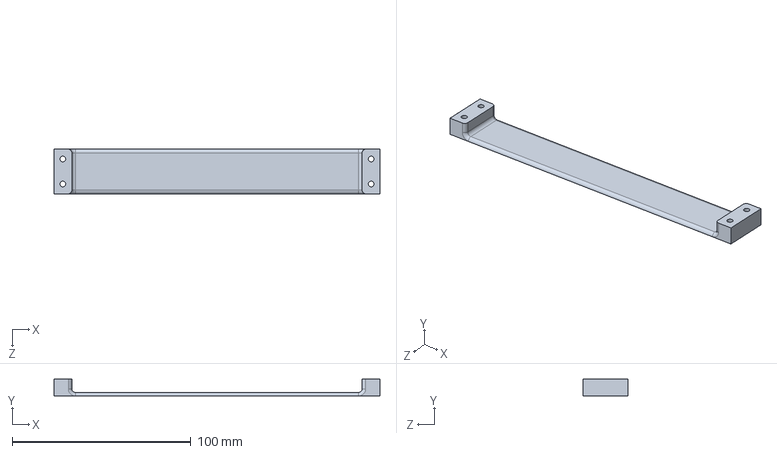
[picture p111: CAD file, 2024-12-27]
3DParts/BatteryHolder.SLDPRT
182.6 x 9.50 x 25.0 mm
