jacobutermoehlen/SCOUT_RobotDog/3DParts/ElectronicsCompartment.SLDPRT

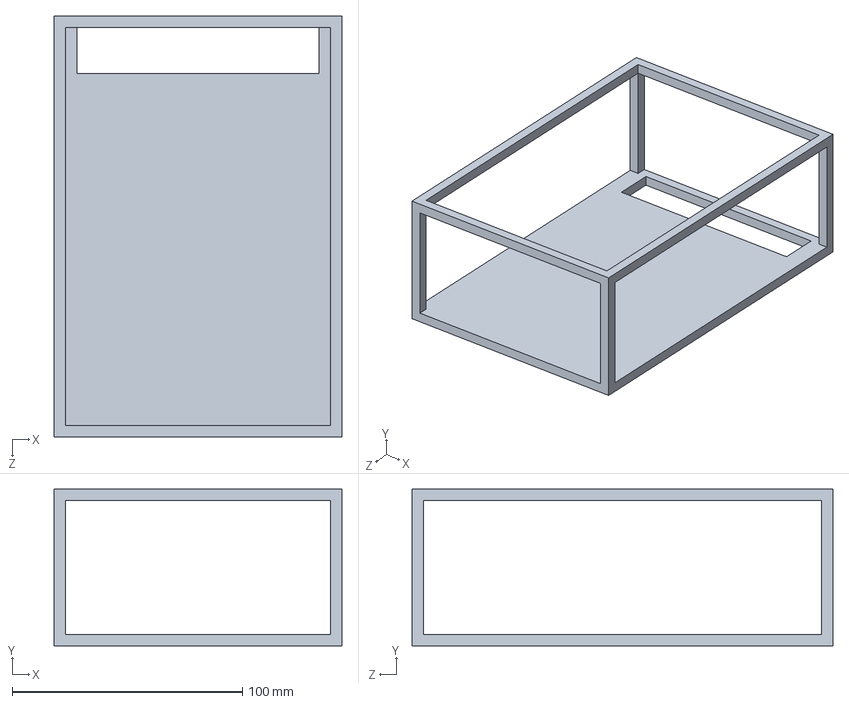
[picture p112: CAD file, 2024-12-27]
3DParts/ElectronicsCompartment.SLDPRT
125.0 x 68.0 x 182.6 mm
