jacobutermoehlen/SCOUT_RobotDog/3DParts/MCP2515_Carrier.SLDPRT

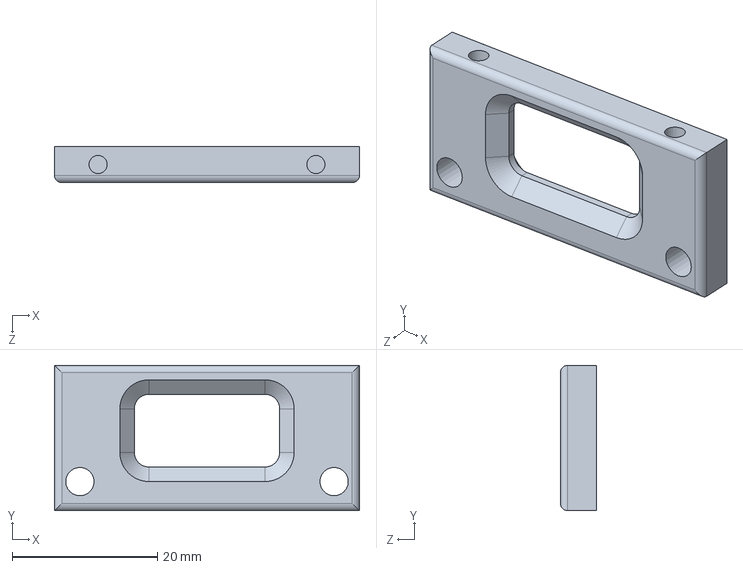
[picture p113: CAD file, 2024-12-27]
3DParts/MCP2515_Carrier.SLDPRT
42.0 x 20.0 x 5.00 mm
