jacobutermoehlen/SCOUT_RobotDog/3DParts/UpperLeg.SLDPRT

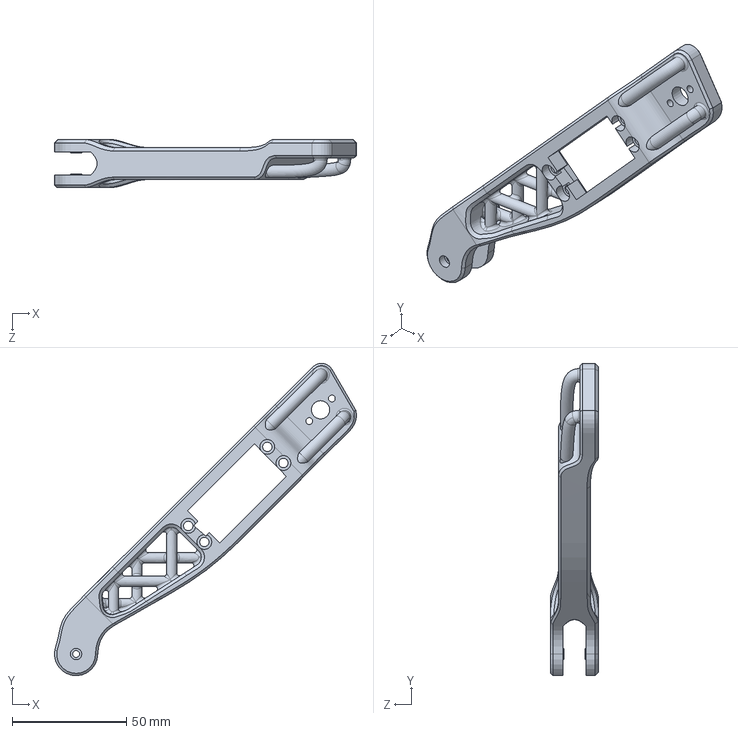
[picture p114: CAD file, 2024-12-27]
3DParts/UpperLeg.SLDPRT
132.4 x 137.0 x 21.0 mm
