jacobutermoehlen/SCOUT_RobotDog/(list of files, cad)

Other CAD files:
3DParts/FootMold/MoldPart2Mirror.SLDPRT
3DParts/FootMold/MoldPart1.SLDPRT
ElektronicParts/PowerDistroBoard_12x.SLDPRT
ElektronicParts/vl53l0x.SLDPRT
3DParts/BackConnectorPlate.SLDPRT
3DParts/LowerLegTest.SLDPRT
3DParts/ElectronicsCage/Part1.STL
3DParts/ElectronicsCage/Part2.STL
3DParts/makeProjectedPlanarWire.x_t
Drawings/SidePanelTest.DXF
Drawings/SidePanelTest.SLDPRT
Drawings/SidePanelTest.STL
ElektronicParts/ICM20948_IMU.SLDPRT
ElektronicParts/makeProjectedPlanarWire.x_t
