jacobutermoehlen/SCOUT_RobotDog/Plakat Texte und Bilder/Bewegung/Bewegung von SCOUT und Teststand.odt

Bewegung von SCOUT und Teststand

Der wichtigste Aspekt unseres Roboters ist die Fortbewegung.

Wir bauten einen Teststand, von welchem SCOUT hängen kann, und seine Beine bewegen kann, ohne den Boden zu berühren. Dadurch konnten wie viele Bewegungen testen ohne, dass SCOUT hinfällt und kaputt gehen kann.

Gehbewegung

Für die Gehbewegung, die jedes Bein folgt, werden Punkte mit einer Bezier-Kurve in einem Koordinatensystem erstellt.

In einem Gehzyklus bewegt sich das Bein zu jedem Punkt, und folgt somit einem bestimmten Weg.

Die Funktion P(t) berechnet Punkte auf der Bezier-Kurve mit drei Kontrollpunkten P0, P1 und P2.
