jacobutermoehlen/SCOUT_RobotDog/Images/TestLeg_Stress_10N.png

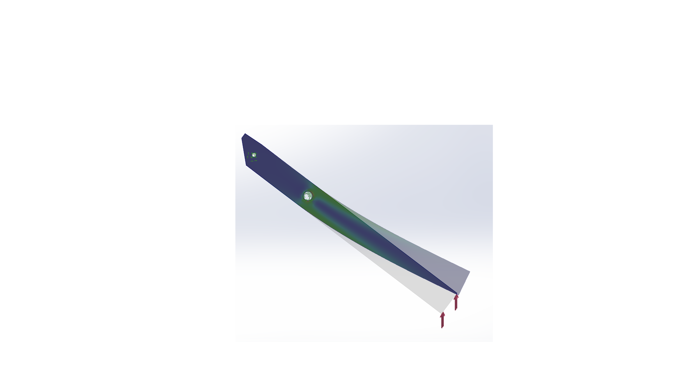
Images/TestLeg_Stress_10N.png
