jacobutermoehlen/SCOUT_RobotDog/Jetson_testCodes/laneFinding/test_image2.png

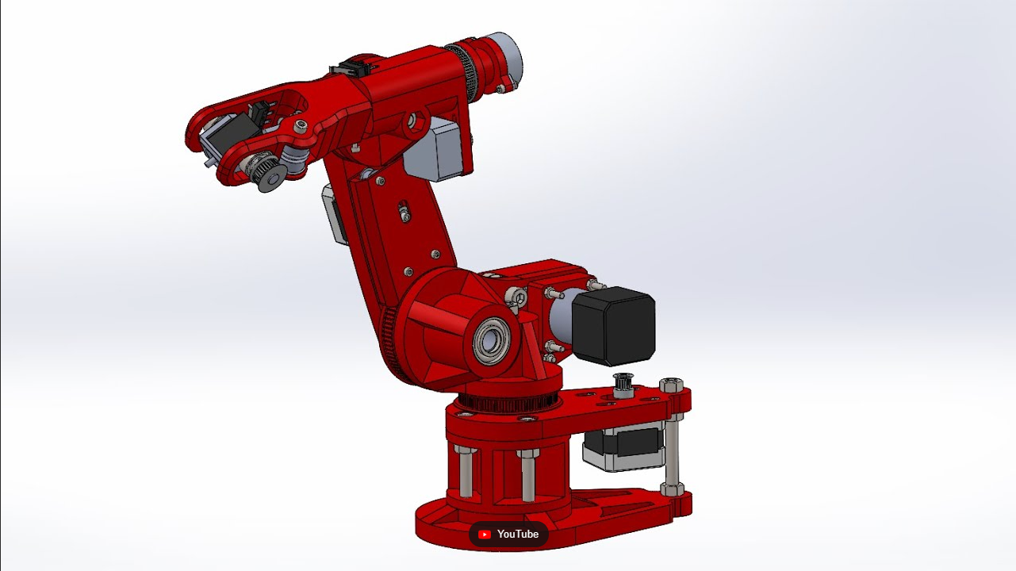
Jetson_testCodes/laneFinding/test_image2.png
