jacobutermoehlen/SCOUT_RobotDog/Jetson_testCodes/laneFinding/test_image4.jpg

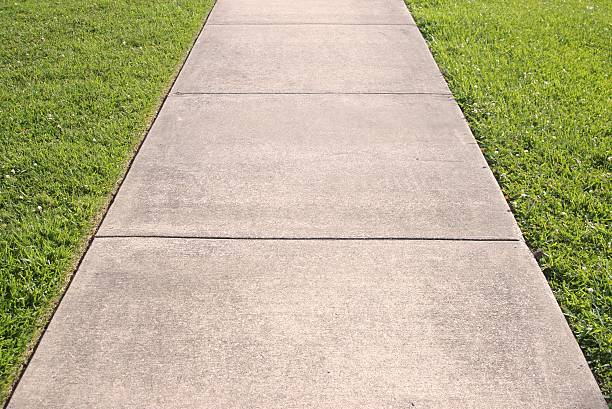
Jetson_testCodes/laneFinding/test_image4.jpg
