jacobutermoehlen/SCOUT_RobotDog/Drawings/Flowchart_SensorESP32_de.pdf

# ESP 32 Code-Diagramm

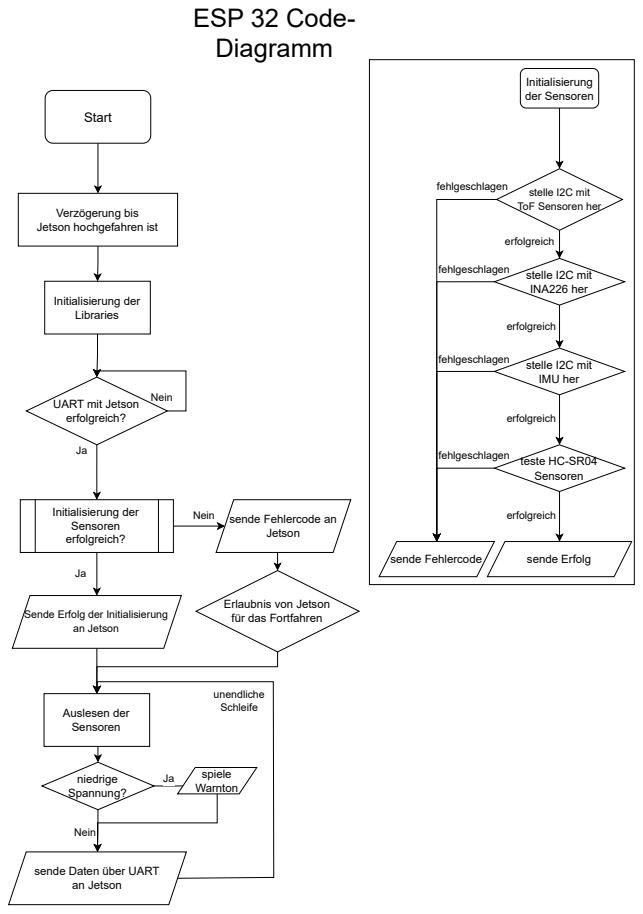
[picture p118: page 1]
Initialisierung der Sensoren; sende Fehlercode; stelle I2C mit INA226 her; stelle I2C mit IMU her; Start; Initialisierung der Sensoren erfolgreich?; fehlgeschlagen; teste HC-SR04 Sensoren; sende Erfolg; erfolgreich; Nein; an Jetson; Auslesen der Sensoren; unendliche Schleife; Initialisierung der Libraries; niedrige; Spannung?; spiele Warnton

stelle I2C mit
ToF Sensoren her

Verzögerung bis
Jetson hochgefahren ist

UART mit Jetson
erfolgreich?

Nein
sende Fehlercode an
Jetson

Erlaubnis von Jetson

für das Fortfahren Sende Erfolg der Initialisierung

sende Daten über UART
an Jetson
