jacobutermoehlen/SCOUT_RobotDog/Drawings/Flowchart_SensorESP32.drawio.pdf

# Sensor ESP32

### failed

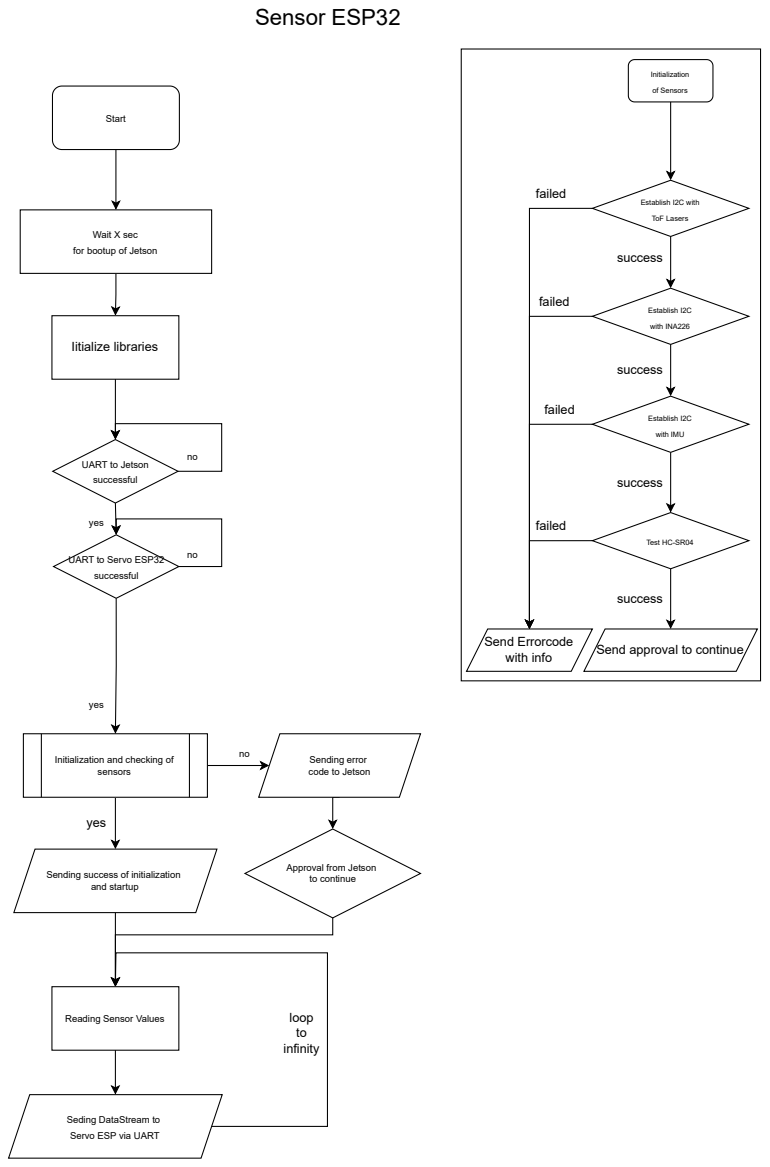
[picture p119: page 1]
Initialization; of Sensors; Establish I2C with; ToF Lasers; Send Errorcode with info; Establish I2C; with INA226; with IMU; Start; sensors; failed; Test HC-SR04; success; yes; and startup; loop to infinity; Iitialize libraries

Wait X sec
for bootup of Jetson

UART to Jetson
successful

UART to Servo ESP32

Send approval to continue

Initialization and checking of

Sending error
code to Jetson

Approval from Jetson

to continue Sending success of initialization

Reading Sensor Values

Seding DataStream to
Servo ESP via UART
