jacobutermoehlen/SCOUT_RobotDog/Drawings/ROBODOG_Relations.pdf

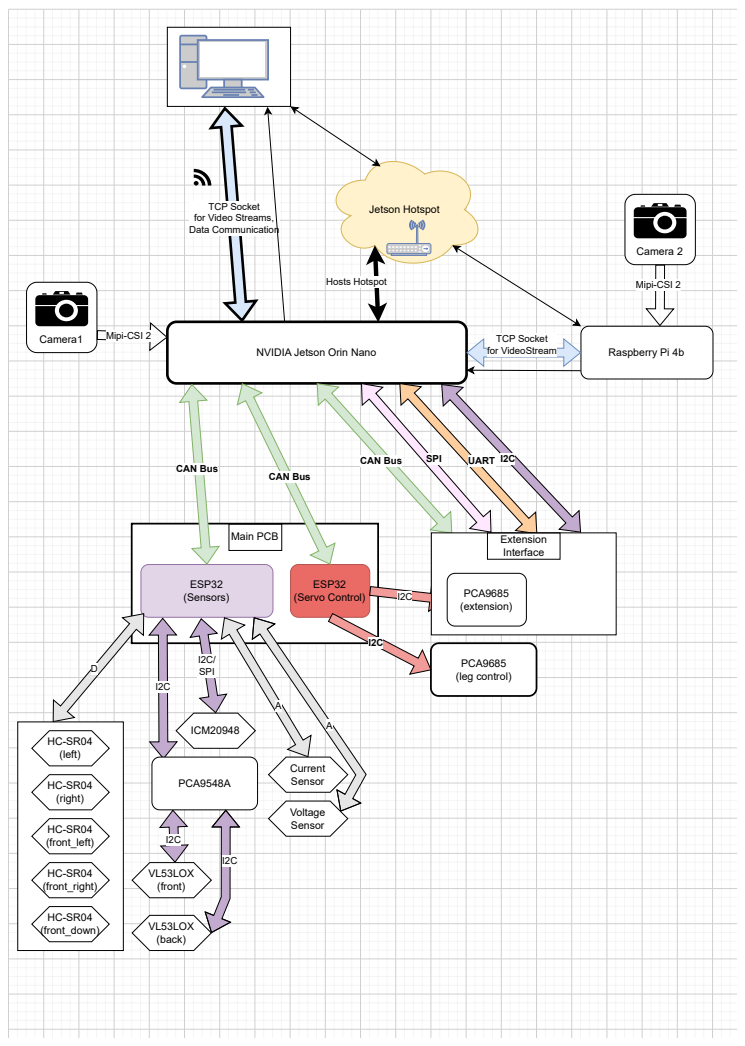
[picture p120: page 1]
Main PCB; ESP32 (Servo Control); ESP32 (Sensors); ICM20948; NVIDIA Jetson Orin Nano; Raspberry Pi 4b; Jetson Hotspot; TCP Socket for VideoStream; Hosts Hotspot; CAN Bus; SPI; UART; PCA9685 (leg control); Camera1; Mipi-CSI 2; Camera 2; HC-SR04 (left); HC-SR04 (right); HC-SR04 (front_left); HC-SR04 (front_right); HC-SR04 (front_down); PCA9548A; VL53LOX (back); VL53LOX (front); I2C/ SPI; Voltage Sensor; Current Sensor; PCA9685 (extension); Extension Interface

TCP Socket
for Video Streams,
Data Communication
