jacobutermoehlen/SCOUT_RobotDog/(commit log)

2025-01-09 21. Commit
    [Partlist for bangle.xlsx]
2025-02-19 45th Commit
    [BackConnectorPlate.SLDPRT, FlummiFoot.SLDPRT, FlummiFoot.STL, FrontConnectorPlate.SLDPRT, KinematicAssembly.SLDASM, LowerLeg.SLDPRT, LowerLeg_LeverArm.SLDPRT, LowerLeg_MoldStub.SLDPRT]
2025-03-14 51st Commit
    [BackConnectorPlate.STL, BackPlate.STL, BackStabeliser.STL, BatteryHolder.STL, BodyEnd.STL, FanHolderSide.STL, FlummiFoot.STL, FrontPlate.STL]
2025-03-14 52nd Commit
    [BackConnectorPlate.STL, BackPlate.STL, BackStabeliser.STL, BatteryHolder.STL, BodyEnd.STL, FanHolderSide.STL, FlummiFoot.STL, FrontPlate.STL]
